Sanuka-cmd-net/lotus-omni/Docs/Architecture.md

# LOTUS OMNI — Architecture Document

## A Superscalar Out-of-Order RISC-V Processor with Systolic Tensor Acceleration,
## Structured Sparsity, and a Congestion-Aware Network-on-Chip

**Author:** Sanuka Nethmira Amarasekara — Lotus Omni (Fabless AI Semiconductor)
**Target FPGA:** Xilinx Artix-7 xc7a200tl-ffv1156-2L
**Timing Status:** Timing-closed OOC @ 80 MHz (WNS +0.252 ns, 0 failing endpoints, 166,090 total endpoints)
**ISA:** RV64I + custom tensor opcode (0x0B)
**RTL Language:** SystemVerilog
**Total Modules:** 30 source files / 35 instantiated modules (all completed, synthesised, and verified)
**Resource Utilisation:** 61,546 LUT (45.73%), 40,250 FF (14.95%), 17 BRAM tiles (4.66%), 64 DSP48E1 (8.65%) — xc7a200t, post-route, zero latches

---

## Table of Contents

1. [Basic Introduction](#1-basic-introduction)
2. [Special Architectures](#2-special-architectures)
3. [Complete Architecture Diagram](#3-complete-architecture-diagram)
4. [Module Status Table](#4-module-status-table)
5. [Front-End Modules](#5-front-end-modules)
6. [Back-End Modules](#6-back-end-modules)
7. [Achievements](#7-achievements)
8. [Development Timeline](#8-development-timeline)
9. [Results Progress](#9-results-progress)
10. [Future Plan](#10-future-plan)
11. [Summary](#11-summary)

---

## 1. Basic Introduction

Lotus Omni is a from-scratch, 4-wide superscalar, out-of-order (OoO) RISC-V core augmented with an AI accelerator subsystem. It was designed, debugged, simulated and timing-closed by a single self-taught engineer, with AI pair-programming assistance. Active RTL development spanned approximately nine months of focused engineering work. The design targets the "AI edge processor" class: a general-purpose OoO scalar pipeline fused with a systolic tensor engine, a three-level memory hierarchy, a TAGE branch predictor, a 2-D mesh Network-on-Chip and credit-based congestion control.

The processor implements the RV64I base integer ISA (64-bit addressing, 32-bit registers with sign/zero extension for word operations) augmented with a custom opcode space at 0x0B for tensor matrix-multiply operations. The scalar pipeline is 4-wide from decode through rename, dispatch, issue, and commit, with a 128-entry Physical Register File (PRF) supporting 8 simultaneous reads and 4 simultaneous writes. Out-of-order execution is managed by partitioned Reservation Stations (implemented depth **RS_DEPTH = 8**, overridden at the top-level integration) with vectorised wakeup and age-based selection, and a 32-entry Reorder Buffer (ROB) enforces in-order retirement with precise exception support.

The tensor accelerator subsystem consists of dual 8x8 systolic arrays (BF16 and INT8), a 2:4 structured sparsity engine, a tensor memory arbiter with CPU-priority arbitration, and a 6-state FSM tensor engine that orchestrates complete 8x8 matrix multiplications in the background while the scalar pipeline continues executing. The memory hierarchy comprises a 32 KB direct-mapped L1 Instruction Cache, a 4 KB write-back L1 Data Cache, and a 16-set 4-way PLRU unified L2 Cache — all using 64-byte cache lines. The L2 is implemented entirely in LUTRAM (zero BRAM), demonstrating a deliberate architectural choice to reserve BRAM resources for the L1I and L1D data arrays.

The on-chip interconnect consists of a 5-port XY-mesh NoC router with per-port FIFO buffers, and a congestion-aware flow control subsystem that deploys credit-based valid/ready flow gates with a PID-like global throttle controller and a 32-cycle sequential divider for utilisation monitoring.

---

## 2. Special Architectures

### 2.1 Out-of-Order Superscalar Execution

Lotus Omni uses a 4-wide superscalar out-of-order pipeline. Up to 4 instructions are fetched, decoded, renamed, dispatched, issued, and committed per cycle. The out-of-order engine uses a physical register file with 128 entries and a free-list for register renaming, partitioned reservation stations with 4 class-specific issue ports, and a reorder buffer for in-order commit. Checkpointed renaming with 8 branch snapshots enables single-cycle mispredict recovery.

### 2.2 TAGE Branch Prediction

The branch predictor uses the TAGE (Tagged Geometric History Length) algorithm with a bimodal base table (1024 entries, 10-bit index), 3 tagged geometric-history tables (256 entries each, 8-bit tags, 3-bit saturating counters), a Branch Target Buffer (BTB, 32 entries), and a Global History Register (GHR). Training updates are pipelined (FIX TAGE-TIMING-02) to meet timing at 80 MHz. A GHR snapshot FIFO (8-deep) ensures training uses the correct historical state.

### 2.3 Outer-Product Broadcast Systolic Arrays (BF16 and INT8)

Both the BF16 and INT8 8x8 systolic arrays use **outer-product broadcast** dataflow. In each feed cycle, one row of activations (a_in_reg[i]) is broadcast to all PEs in row i, and one column of weights (b_in_reg[j]) is broadcast to all PEs in column j. Each PE maintains a **local accumulator** that independently accumulates the partial products over successive feed cycles, computing C[i][j] = SUM_k A[i][k] * B[k][j] without any vertical inter-PE data chain. The clear_acc signal is registered alongside the input data (V5.1 / V2.0 alignment fix) so that accumulator resets align exactly with the first product arriving at the PE adder.

### 2.4 2:4 Structured Sparsity (NVIDIA Ampere/Hopper Style)

The sparsity engine implements 2:4 structured sparsity: for every group of 4 weight values, the two with the largest absolute magnitude are retained and the other two are zeroed. A 3-bit metadata value encodes the selection (6 possible combinations from C(4,2) = 6, fitting exactly in 3 bits). This halves tensor bandwidth and doubles effective throughput. The CSR `sparsity_ctrl` defaults to enabled (`0x01`), but sparsity is disabled at the top level (`assign sparsity_en_csr = 1'b0`) for Artix-7 bring-up; the engine is fully synthesised and can be activated by changing a single assign.

### 2.5 Credit-Based Congestion-Aware Flow Gates

The congestion control subsystem deploys credit-based valid/ready flow gates at the LSU, DRAM, NoC, and tensor boundaries. Each gate contains a 4-deep skid FIFO (LUTRAM-inferred), a credit counter, a throttle counter, and a duty-cycle monitor. A global throttle controller uses a PID-like proportional controller with a 32-cycle shift-subtract sequential divider (FIX V2.2: replaced a combinational divider that was a timing bomb) to compute utilisation percentages and adjust the injection rate.

### 2.6 Checkpointed Register Renaming

The renamer maintains 8 branch checkpoints (RAT snapshot + free-list head/tail/count), enabling single-cycle restoration of architectural state on mispredict recovery. Intra-bundle forwarding handles WAW hazards within the same 4-wide dispatch bundle without waiting for CDB broadcast. The output is pipelined through a registered stage (FIX REN-TIMING-02) to break a critical timing path.

### 2.7 ASIC-Portable Coding Style

The entire codebase follows ASIC-portable conventions: synchronous resets on all DSP-mapped modules (enabling DSP48 SR packing), reset-free BRAM write paths for proper SRAM inference, one-hot arbitration for scalable muxing, and no FPGA-specific DSP attributes in the BF16 multiplier (V4.0). The BF16 multiplier uses a direct 8x8 multiply that synthesis tools can map to the optimal ASIC multiplier topology (Wallace tree, Booth encoded, or array).

---

## 3. Complete Architecture Diagram

The following line diagram illustrates the complete data-flow architecture of Lotus Omni, including all modules, data paths, memory hierarchy, tensor accelerator subsystem, and Network-on-Chip interconnect.

```
                         LOTUS OMNI — COMPLETE ARCHITECTURE
                         ====================================

                          +------------------------------ FRONT-END -----------------------------+
                          |                                                                      |
   PC ------>+-------  req  +-----------+  512b  +------------+ 16xuop +------------+ 4xren_uop  |
   ^        |  IFU   |----->| L1I CACHE|------>|  DECODER   |------>|  RENAMER   |----------+  |
   |        |16-wide |<-----|512-set DM|       | 16-wide    |       |RAT+FreeLst|          |  |
   +--------+---^----+ hit  +----^-----+       +------------+       +-----^------+          |  |
   |  pred  |     |           |                        |                | save/restore    |  |
   | +------+-----+           |            +-------------+           | checkpoint      |  |
   +--|   TAGE     |          +----------->|   L2 CACHE  |<----------+ |                 |  |
      | +BTB +GHR  |                      |16-set 4-way  |            | |                 |  |
      +------------+                      |    PLRU     |            | |                 |  |
                          +---------------+------^------+------------+ | |                 |  |
                          |                      | 1024b DRAM beat  | | |                 |  |
                          |               +------v-----+             | | |                 |  |
                          |               | DRAM GATE  |             | | |                 |  |
                          |               +-----+------+             | | |                 |  |
                          +---------------------+--------------------+ | |                 |  |
                                                v                      | |                 |  |
                                           [ DRAM PORT ]               | |                 |  |
                                                                       | |                 |  |
  +----------------------------- BACK-END ------------------------------+-+-----------------+--+
  |                                       +----------------------------v-v--------+         |  |
  |  4xren_uop +---------------+  dispatch |           ROB (32)                |         |  |
  | +-------->| RESERVATION   |--------->| in-order commit . banked RAM    |         |  |
  | |         |  STATIONS     |          +-------+-------------^-----------+         |  |
  | | wakeup  | (partitioned) |                  |commit(4)     |cdb(4, registered)   |  |
  | | <-------+--|---+---+----+                  v              |                     |  |
  | |         |  |   |   |   |              +-----------+  +----+-------------------+ |  |
  | |         v  v   v   v   |              |    PRF    |  |       CDB MUX          | |  |
  | |        +----+ +--+ +----+--------+   |128x64 8R4W|<-+- ALU|BR|LD|CSR+TENSOR  | |  |
  | |        |ALU | |BR | |AGU  |TENSOR/  |  +-----^----+  +--^----^----^------^-----+ |  |
  | |        |    | |   | |+LSQ | CSR     |       |rd(8)      |    |    |      |       |  |
  | |        +--^-+ +--^-+ +--^--+--^-----+       |wr(4)      |    |    |      |       |  |
  | |           |      |      |     |               |           |    |    |      |       |  |
  | +-----------+------+------+-----+---------------+           |    |    |      |       |  |
  |                                                           |    |    |      |       |  |
  |  issue(4)                                                  |    |    |      |       |  |
  +-----------------------------------------------------------+    |    |      |       |  |
                                                                   |    |    |      |       |  |
      +------------------------------------------------------------+    |    |      |       |  |
      |                                                                 |    |      |       |  |
      |  +--------------------------------------------------------------+    |      |       |  |
      |  |                                                                   |      |       |  |
      |  |  +----------------------------------------------------------------+      |       |  |
      |  |  |                                                                          |       |  |
      v  v  v  v  v  v  v                                                                  |       |  |
    [P0][P1][P2][P3] issue ports --> ALU / Branch / AGU+LSQ / Tensor+CSR                |       |  |
                               |                |                                         |       |  |
                               |   +------------+---------------+                         |       |  |
                               |   |  LSQ (16) -- STL fwd -->L1D |                         |       |  |
                               |   |        |            +------v------+                  |       |  |
                               |   |        +----------->|  L1D CACHE  |                  |       |  |
                               |   |                     |64-line WB   |                  |       |  |
                               |   |                     +------^------+                  |       |  |
                               |   |                            | miss                    |       |  |
                               |   |                     +------v------+                  |       |  |
                               |   |                     | TENSOR MEM  |<-- tensor req    |       |  |
                               |   |                     |  ARBITER    |    (background)  |       |  |
                               |   |                     | CPU-priority|                  |       |  |
                               |   |                     +------^------+                  |       |  |
                               |   |                            |                         |       |  |
                               |   |   +------------------------v-------------------------+      |       |  |
                               |   |   |  TENSOR ENGINE FSM (IDLE->MEM->FEED->DRAIN->WB)|     |       |  |
                               |   |   |   +---------------+   +---------------+          |     |       |  |
                               |   |   |   | 8x8 BF16 SYS  |   | 8x8 INT8 SYS  |          |     |       |  |
                               |   |   |   | outer-product |   | outer-product |          |     |       |  |
                               |   |   |   | broadcast     |   | broadcast     |          |     |       |  |
                               |   |   |   +-------^-------+   +-------^--------+         |     |       |  |
                               |   |   |           |            +-------v--------+         |     |       |  |
                               |   |   |   +-------v-------+    | SPARSITY 2:4 |          |     |       |  |
                               |   |   |   | 2:4 COMPRESS  |<---|  engine       |          |     |       |  |
                               |   |   |   +---------------+    +---------------+          |     |       |  |
                               |   |   +---------------------------------------------------+      |       |  |
                               |   +----------------------------------------------------------+      |       |  |
                               |                                                                  |       |  |
                               |   +--------------------------------------------------------------+   |       |  |
                               +-->|  NOC ROUTER (5-port XY, RR) --> flow gates --> tx/rx       |---+       |  |
                                   +--------------------------------------------------------------+           |  |
                                                                                                          |  |
                                                                                                          +--+

  DATA-FLOW SUMMARY:
  ================
  Scalar path:  Fetch --> L1I --> Decode --> Rename --> RS --> {ALU, BR, AGU/LSQ, TEN/CSR} --> CDB --> PRF/ROB --> Commit
  Memory path:  LSQ --> L1D --> (miss) --> Arbiter --> L2 --> (miss) --> DRAM-gate --> DRAM
  Tensor path:  Engine --> Arbiter --> L1D --> L2
  NoC path:     Router (5-port XY mesh) --> Flow gates --> tx/rx --> neighbouring tiles
```

---

## 4. Module Status Table

All 30 source files are **completed**: synthesised, behaviourally simulated, and (for the full core) timing-closed out-of-context at 80 MHz. The 30 files map to 35 instantiated modules; 4 internal submodules (`decoder_diq_bank`, `rs_payload_bank`, `pf_fifo_4deep`, `noc_fifo_storage`) are generated or instantiated within their parent modules.

| # | Module | Function | Status |
|---|---|---|---|
| 1 | `lotus_ifu_masterpiece` | 16-wide fetch, deadlock-free request channel (V1.1) | Completed |
| 2 | `lotus_l1i_cache` | 512-set DM I-cache, 32 KB, 64 B/line, BRAM, 5-state FSM (V4.2) | Completed |
| 3 | `lotus_tage_predictor` | TAGE+BTB branch predictor with pipelined training (V2.8) | Completed |
| 4 | `lotus_decoder_masterpiece` | 16-wide decode, 128-entry 16-bank LUTRAM DIQ (V4.0) | Completed |
| 5 | `lotus_renamer_masterpiece` | RAT + free-list, 8 branch checkpoints, registered output (V3.3) | Completed |
| 6 | `lotus_reservation_station_v4` | Partitioned RS, vectorised wakeup/selection, pure-arith occupancy (V5.8) | Completed |
| 7 | `lotus_prf` | 128x64b 8R/4W PRF, registered one-hot arbitration, deferral queue | Completed |
| 8 | `lotus_alu_masterpiece` | RV64I ALU, 2-stage EX1/EX2 pipeline with OR-AND forwarding (V4.3 - ALU-DEADLOCK-001) | Completed |
| 9 | `lotus_branch_exec` | Branch/jump resolve, mispredict detection, proper branch_tag (V2.1 - BRANCH-DEADLOCK-01) | Completed |
| 10 | `lotus_agu` | Address generation, 9-bit wmask, misalign detect, latch-free (V1.2) | Completed |
| 11 | `lotus_lsq_masterpiece` | 16-entry SQ, CAM store-to-load forwarding, registered drain (V3.8) | Completed |
| 12 | `lotus_l1d_cache` | 64-line WB data cache, 4 KB, 64 B/line, 512-bit resp, 7-state 
FSM w/ MMIO_SINK (V8.1) | Completed |
| 13 | `lotus_l2_cache` | 16-set 4-way PLRU unified L2, LUTRAM-only, 4-entry queue (V7.6) | Completed |
| 14 | `lotus_prefetcher` | Stride prefetcher, RPT + 4-deep queue, fixed FIFO (V1.6) | Completed |
| 15 | `lotus_rob_masterpiece` | Banked-RAM ROB, 32-entry, 4-wide commit, registered CDB (V8.3) | Completed |
| 16 | `lotus_tensor_engine` | MATMUL FSM, 6-state, internal CDB writeback, dataflow-aligned (v3.0.0) | Completed |
| 17 | `lotus_bf16_systolic_array_8x8_v3` | 8x8 BF16 outer-product broadcast, local accumulation (V5.1) | Completed |
| 18 | `lotus_int8_systolic_array_8x8` | 8x8 INT8 outer-product broadcast, local accumulation (V2.0) | Completed |
| 19 | `lotus_bf16_tensor_pe` | DSP-mapped BF16 MAC PE, 3-stage, local acc, operand isolation (V10.0) | Completed |
| 20 | `lotus_sparsity_engine_v3` | 2:4 structured sparsity compressor, backpressure hold (V3.4 - SPARSE-HS-001) | Completed |
| 21 | `lotus_tensor_mem_arbiter` | CPU-priority L1D arbiter, 12 SVA assertions (v2.1.0) | Completed |
| 22 | `lotus_noc_router_masterpiece` | 5-port XY mesh NoC router, LUTRAM FIFO, set/reset safe (V3.2 - NOC-P0-001) | Completed |
| 23 | `congestion_aware_flow_gate` | Credit-based flow gate, 4-deep LUTRAM skid FIFO, credit/throttle counters (V2.3 - DEADLOCK FIX) | Completed |
| 24 | `flow_gate_array` | Parametric array of N parallel flow gates with global throttle (V1.0) | Completed |
| 25 | `global_throttle_controller` | PID-like proportional controller, 32-cycle sequential divider (V1.0) | Completed |
| 26 | `lotus_csr` | Machine-mode CSRs + custom tensor/sparsity CSRs + FENCE/FENCE.I (V1.1) | Completed |
| 27 | `lotus_pmu` | 13-counter hardware PMU, shift-based IPC, pipelined counters | Completed |
| 28 | `lotus_axi4_wrapper` | AXI4-Lite control-plane, internal tensor CDB, glitch-free reset (V2.0) | Completed |
| 29 | `lotus_omni_core_top_v2` | Top-level integration, timing pipelines, all bugs fixed | Completed |
| 30 | `lotus_pkg` | Shared parameter/typedef package, 30+ structs (uop_t, rs_entry_t, etc.) | Completed |
| 31 | `lotus_bf16_mult` | ASIC-portable BF16 multiplier, 3-stage exp/mantissa pipeline (V4.0) | Completed |
| 32 | `lotus_tensor_pe` | INT8 MAC PE, 3-stage, DSP48E2-ready, saturation, sparsity skip (V3.0) | Completed |
| 33 | `decoder_diq_bank` | 8-entry LUTRAM DIQ bank (submodule of decoder, 16 banks total) | Completed |
| 34 | `rs_payload_bank` | RS entry payload storage bank (submodule of reservation station) | Completed |
| 35 | `pf_fifo_4deep` | 4-deep prefetch FIFO (submodule of stride prefetcher) | Completed |
| 36 | `noc_fifo_storage` | NoC router FIFO storage (submodule of NoC router) | Completed |

All 30 source files are **completed**: synthesised, behaviourally simulated, and (for the full core) timing-closed out-of-context at 80 MHz. The 30 files map to 35 instantiated modules; the additional files include supporting modules (`lotus_pkg`, `lotus_bf16_mult`, `lotus_tensor_pe`, `lotus_axi4_wrapper`) and 4 internal submodules (`decoder_diq_bank`, `rs_payload_bank`, `pf_fifo_4deep`, `noc_fifo_storage`) generated or instantiated within their parent modules.

---

## 5. Front-End Modules

The front-end is responsible for fetching instructions from memory, predicting branch directions and targets, decoding RISC-V instructions into micro-operations, and renaming architectural registers to physical registers to eliminate false dependencies. It operates as a wide 16->4 funnel that feeds the back-end's out-of-order engine.

---

### 5.1 Instruction Fetch Unit — `lotus_ifu_masterpiece`

**Module Description**

The Instruction Fetch Unit (IFU) is the entry point of the pipeline. It fetches one 64-byte (16-instruction) cache line per cycle from the L1 Instruction Cache, maintaining the Program Counter (PC). The IFU accepts branch redirect targets from the TAGE predictor and pipeline flush signals from the back-end (on mispredict or exception). A critical design decision is the decoupled request channel: if the back-end stalls, the IFU does not deadlock — it simply stops issuing new requests but can still accept and process redirects (FIX IFU-001). This property of guaranteed forward progress is essential for the health of the entire pipeline, since a deadlocked fetcher would permanently halt the processor.

**Mathematical Formulation (with Worked Example)**

The PC update follows a three-way mux governed by flush, stall, and prediction conditions:

```
             +-- flush_target                          if flush
             |
PC(t+1)  =  +-- PC(t)                                 if stall OR flush OR backend_stall
             |
             +-- pred_taken ? pred_target : PC(t)+64   otherwise
                                                        (Eq. F1)
```

Where:
- `backend_stall = out_valid AND NOT dec_ready` (the decoder cannot accept more instructions)
- `stall = NOT l1i_req_ready` (the L1I cache cannot accept a new request this cycle)

**Worked Example:**
- Scenario 1: `PC = 0x8000_0000`, no branch predicted, no stall.
  - `PC(t+1) = 0x8000_0000 + 64 = 0x8000_0040` (sequential fetch of the next 16 instructions)
- Scenario 2: TAGE predicts taken branch to target `0x8000_1000`.
  - `PC(t+1) = 0x8000_1000` (non-sequential redirect to the predicted target)
- Scenario 3: Back-end stall (`backend_stall = 1`).
  - `PC(t+1) = 0x8000_0040` (PC holds, no new request issued, but the IFU stays alive to process flushes)

**Contribution to the Chip**

The IFU sustained the 16-wide fetch bandwidth needed for 4-wide dispatch with decoupling that prevents fetch-deadlock. FIX IFU-001 separated the cache request path from the backend stall path, ensuring the fetcher can continue making forward progress (accepting redirects, maintaining liveness) even when the decoder is temporarily unable to accept new instructions. This decoupling is essential in a deep out-of-order pipeline where back-end stalls (ROB full, LSQ full, cache misses) are frequent.

---

### 5.2 L1 Instruction Cache — `lotus_l1i_cache`

**Module Description**

The L1 Instruction Cache is a 512-set direct-mapped cache with 64-byte (512-bit) cache lines, yielding 32 KB of instruction storage. It uses a 5-state FSM: `IDLE -> READ_RAM -> READ_REG -> COMPARE -> ALLOCATE`. The data and tag arrays are BRAM-inferred (`(* ram_style = "block" *)`) with no reset on the SRAM arrays to ensure proper BRAM inference on both FPGA and ASIC targets. A separate `valid_bits` array (flip-flops, resettable) tracks which cache lines contain valid data. The BRAM output is captured in a registered stage (`READ_REG` absorbs the BRAM output register latency) before tag comparison. FIX V4.1 corrected the array declarations from `[NUM_SETS-1]` to `[0:NUM_SETS-1]` to ensure all 512 elements are properly synthesised (SYNTH-8-324).

**Mathematical Formulation (with Worked Example)**

```
index   = PC[INDEX_BITS+OFFSET_BITS-1 : OFFSET_BITS]     (9 bits for 512 sets)   (Eq. F2)

is_hit  = valid_read_q AND (tag_read_q == addr_tag)                                  (Eq. F3)

evict_line = addr_index  (direct-mapped: only one candidate)                        (Eq. F4)
```

**Worked Example:**
- `PC = 0x8000_1000`, `NUM_SETS = 512`, `OFFSET_BITS = 6`.
- `index = PC[14:6] = 0x040` (set 64).
- `tag = PC[63:15]` (49-bit tag, upper address bits).
- FSM cycle trace: `IDLE` (req accepted) -> `READ_RAM` (BRAM address registered) -> `READ_REG` (BRAM output captured) -> `COMPARE` (tag match: hit? if yes, return data; if no, issue memory request) -> `ALLOCATE` (fill from memory on miss).

**Contribution to the Chip**

The L1I Cache supplies 16 instructions per cycle to the decoder, sustaining the front-end's fetch bandwidth. The 32 KB size (512 sets x 64 B) provides good instruction locality for typical program working sets. The reset-free BRAM design is critical for both area efficiency (avoiding flip-flop implementation) and ASIC portability (hardware SRAM cells cannot be reset in a single cycle). The V4.1 array declaration fix (SYNTH-8-324) ensured that all 512 cache entries are properly synthesised rather than a single-element array.

---

### 5.3 TAGE Branch Predictor — `lotus_tage_predictor`

**Module Description**

The TAGE predictor uses a bimodal base table (1024 entries x 2-bit saturating counters, indexed by `PC[9:2]`) and 3 tagged geometric-history tables (T1/T2/T3, each 256 entries x 3-bit counters with unique tags). Each table uses a different GHR history length for varying prediction power at different branch correlation distances. A Branch Target Buffer (BTB, 32 entries) caches branch targets. The Global History Register (GHR) tracks the last 16 branch outcomes. Training updates are pipelined (FIX TAGE-TIMING-02): table writes use registered indices and tags from Stage 1, breaking a critical combinational path from the prediction output to the update logic. A GHR snapshot FIFO (8-deep, FIX TAGE-001) captures the GHR state at fetch time and replays it at training time, ensuring correct training alignment despite the pipeline latency between fetch and resolution.

**Mathematical Formulation (with Worked Example)**

```
bimodal_idx = PC[9:2]                                              (Eq. F5)

t{i}_idx = PC ^ GHR[hist_len{i}-1 : 0]                           (Eq. F6)

prediction = longest-match tagged table that hits, else bimodal

ctr_update = clamp( ctr +/- 1, 0, max )                           (Eq. F7)
```

Counter update: `ctr <- clamp(ctr +/- 1, 0, 7)`. New allocation: `ctr = 4` (if taken) or `ctr = 3` (if not-taken) — weakly biased toward the observed direction.

**Worked Example:**
- `PC[9:2] = 0x10` (binary: `0001_0000`), `GHR = 0x000F` (binary: `0000_0000_0000_1111`).
- `t1_idx = 0x10 XOR 0x0F = 0x1F` (index 31 in T1 table).
- `t1_tag = 0x10 XOR 0x0F = 0x1F` (tag to compare).
- Suppose T1[31] is valid, its tag matches 0x1F, and its counter is 5 (binary `101`).
- Prediction: `ctr[2] = 1` -> **taken**.
- If the branch is actually taken, the counter increments: `5 + 1 = 6`.
- If the branch is actually not-taken (misprediction), the counter decrements: `5 - 1 = 4`.

**Contribution to the Chip**

The TAGE predictor cuts control-hazard flushes, which are one of the most expensive events in a deep pipeline. Each saved mispredict is a full pipeline refill (10+ cycles) recovered. In a typical workload with 15-25% branch instructions, even a modest accuracy improvement of 5% over a simple bimodal predictor translates to significant IPC gains. The GHR-snapshot FIFO (the key innovation for training alignment) and the pipelined training update (TAGE-TIMING-02) ensure the predictor trains on the correct global history state, preventing accuracy degradation.

---

### 5.4 Decoder — `lotus_decoder_masterpiece`

**Module Description**

The Decoder is a 16-wide parallel instruction decoder that converts raw RISC-V 32-bit instruction words into internal micro-operation (`uop_t`) structures. Decoded micro-operations are buffered in a 128-entry Decoded-Instruction Queue (DIQ), which is striped across 16 LUTRAM banks to avoid the read-port bottleneck that a monolithic RAM would create. The decoder dispatches 4 micro-operations per cycle to the renamer, matching the back-end's 4-wide dispatch bandwidth. A key timing optimisation (FIX DEC-TIMING-001) replaced a 16-iteration accumulator loop with a parallel `$countones` and simple min logic, and FIX DEC-TIMING-002 replaced a 16-to-1 priority encoder with a barrel-rotate write mux — together reducing the combinational depth from 75 logic levels to just 4. FIX DEC-TIMING-003 changed to synchronous reset to eliminate async reset recovery timing violations.

**Mathematical Formulation (with Worked Example)**

```
req     = popcount( valid_mask[15:0] )                              (Eq. F8)
count'  = count + enq - ndis        (9-bit intermediate, no wrap)     (Eq. F9)
bank b  = instr i where i = (b - tail[3:0]) mod 16                    (Eq. F10)
gaddr   = (tail + i) mod 128                                         (Eq. F11)
```

**Worked Example:**
- `valid_mask = 0x00FF` (lower 8 instructions are valid in the current fetch bundle).
- `req = popcount(0x00FF) = 8` (8 valid instructions to decode).
- With `tail = 3`, instruction `i=0` maps to bank `b = (0 - 3) mod 16 = 13`, and `gaddr = (3 + 0) mod 128 = 3`.
- Instruction `i=1` maps to bank `b = 14`, `gaddr = 4`.
- The barrel-rotate write mux maps each instruction to its target bank in a single level of MUX logic, instead of the cascaded priority chain that caused the timing violation.

**Contribution to the Chip**

The Decoder sustains the 16->4 funnel without becoming a bottleneck. The parallel popcount and barrel-rotate architecture removed the two deepest combinational chains in the front-end, directly contributing to timing closure. Without this fix, the decoder alone would have prevented the design from reaching 80 MHz. The 128-entry DIQ provides buffering that absorbs the mismatch between the 16-instruction fetch width and the 4-instruction dispatch width, allowing the fetch and rename stages to operate independently. The DIQ banks use flattened struct arrays (FIX DEC-P1-001) for perfect LUTRAM inference, with each field (`pc`, `opcode`, `dest_reg`, `src1_reg`, `src2_reg`, `imm_data`, `funct3`, `funct7`, `is_tensor_op`, `precision`, `is_branch`, `is_memory`, `is_illegal`, `is_csr`, `valid`) stored as a separate `(* ram_style = "distributed" *)` array.

---

### 5.5 Renamer — `lotus_renamer_masterpiece`

**Module Description**

The Renamer maps the 32 architectural registers defined by the RISC-V ISA onto 128 physical registers in the Physical Register File (PRF). This register renaming eliminates false dependencies — Write-After-Write (WAW) and Write-After-Read (WAR) hazards — so that the out-of-order engine can exploit genuine data parallelism (Read-After-Write, or RAW, dependencies). The renamer maintains a Register Alias Table (RAT) that maps each architectural register to its current physical register, and a free-list that tracks which physical registers are available for allocation.

The renamer also performs intra-bundle forwarding: if multiple instructions in the same 4-wide dispatch bundle write to the same architectural register (e.g., two back-to-back `addi x1, x0, 1`), the later instruction sees the earlier one's physical destination without waiting for the CDB. Eight checkpointed snapshots (RAT + free-list head/tail/count) are maintained for single-cycle branch mispredict recovery. The output is pipelined through a registered stage (FIX REN-TIMING-02) to break a critical timing path. Shallow allocation and commit count logic (FIX REN-TIMING-01) keeps the combinational depth minimal. Additional fixes include complete free-list reset initialisation (REN-003), free-list value wrap-around skipping p0 (REN-004), and synchronous reset (REN-005).

**Mathematical Formulation (with Worked Example)**

```
p_dest[i] = FL[ ( fl_head + SUM_{j<i} a_j ) mod 128 ],  a_j = [dest_j != 0]   (Eq. F12)

fl_head' = fl_head + SUM a_i
fl_tail' = fl_tail + SUM c_i                                               (Eq. F13)

rename_ready = ( fl_count >= 4 )                                           (Eq. F14)
```

Where `a_j = 1` if instruction `j` in the bundle writes a non-zero architectural register (i.e., it needs a new physical register), and `c_i = 1` when a committed instruction frees its old physical register.

**Worked Example:**
- `fl_head = 40`, and the dispatch bundle has two writers: slot 0 writes to `x3` and slot 2 writes to `x5`.
- `a_0 = 1` (x3 != 0), `a_1 = 0` (slot 1 has no destination), `a_2 = 1` (x5 != 0), `a_3 = 0`.
- `p_dest[0] = FL[(40 + 0) mod 128] = FL[40]` (first available physical register).
- `p_dest[2] = FL[(40 + 1) mod 128] = FL[41]` (second available physical register).
- `fl_head' = 40 + 1 + 1 = 42` (two physical registers consumed).
- `rename_ready = (fl_count >= 4)` — if fewer than 4 physical registers are free, the renamer back-pressures the decoder.

**Contribution to the Chip**

The Renamer is the enabler of out-of-order execution. Without register renaming, the processor could only issue instructions in program order because of false dependencies. By eliminating WAW and WAR hazards, the renamer allows the 4 issue ports to extract instruction-level parallelism from independent operations — for example, issuing two independent `add` instructions in the same cycle even if a previous (but unrelated) `mul` is still executing. The 8-checkpoint system bounds the branch-misprediction penalty to a single cycle of state restoration, which is critical for the TAGE predictor's effectiveness.

---

## 6. Back-End Modules

The back-end is the out-of-order execution engine. It receives renamed micro-operations from the front-end, dispatches them into partitioned Reservation Stations where they wait for their operands, issues them to execution units when ready, broadcasts results on the Common Data Bus, and retires completed instructions in program order through the Reorder Buffer. The back-end also contains the memory subsystem (LSQ, L1D, L2, prefetcher), the tensor accelerator subsystem (systolic arrays, sparsity engine, tensor memory arbiter), and the on-chip interconnect (NoC router, congestion flow gates).

---

### 6.1 Reservation Stations — `lotus_reservation_station_v4`

**Module Description**

The Reservation Stations (RS) are the heart of out-of-order execution — they implement the dataflow firing model where instructions execute as soon as their operands are ready, regardless of their original program order. The RS is partitioned into 4 class-specific ports: Port 0 (ALU), Port 1 (Branch), Port 2 (Memory/AGU/LSQ), and Port 3 (Tensor/CSR). Each entry stores the micro-operation's opcode, destination physical register, source physical register numbers, operand validity bits, and the ROB index for in-order tracking.

The Reservation Station (RS) is a partitioned structure with an **implemented depth of 8 entries** (RS_DEPTH = 8, set by top-level override in `lotus_omni_core_top_v2`; note: the `lotus_pkg` comment still reads 16, which is stale — the actual synthesised depth is 8). Entries wait for operand readiness through two mechanisms: (1) checking `prf_ready_bits` (set when the PRF write completes), or (2) waking up from CDB broadcasts (when another execution unit writes a result that matches a waiting entry's source register). Once both operands are ready, the entry becomes a candidate for issue. A vectorised parallel matcher selects the oldest ready entry per port, and the selected entry is issued to the corresponding execution unit. The issue count is pipelined (FIX RS-TIMING-02) and the occupancy counter uses pure arithmetic without conditional clamps (FIX RS-TIMING-03), which removed a 2.282 ns critical path. The RS payload is stored in isolated `rs_payload_bank` sub-modules (FIX RS-006) with registered write addresses for distributed RAM inference.

**Mathematical Formulation (with Worked Example)**

```
r{k}_s' = r{k}_s OR  ( cdb_valid[p] AND (cdb_p_dest[p] == p_src{k}_s) )    (Eq. B1)

occ'   = occ + dispatch_count - issue_count_q       (no clamps needed)     (Eq. B2)

rs_ready = NOT( occ >= RS_DEPTH - 4 )                                      (Eq. B3)
```

**Worked Example:**
- Current occupancy `occ = 6`, dispatch 2 new entries, issue 1 entry.
- `occ' = 6 + 2 - 1 = 7`.
- `rs_ready = NOT(7 >= RS_DEPTH - 4)`. If `RS_DEPTH = 8`, then `rs_ready = NOT(7 >= 4) = NOT(true) = 0` (not ready to accept more dispatches).
- CDB broadcast: port 2 writes `p_dest = 17` with `cdb_valid[2] = 1`.
- Every RS entry waiting on source register 17 has its ready bit set to 1 in a single cycle (Eq. B1).

**Contribution to the Chip**

The Reservation Stations implement dataflow firing — the fundamental mechanism of out-of-order execution. The occupancy arithmetic fix (replacing comparators with pure add/subtract) removed a 2.282 ns critical path that was one of the top timing violations in the design. The partitioned port structure ensures that ALU, branch, memory, and tensor operations do not compete for the same issue bandwidth.

---

### 6.2 Physical Register File — `lotus_prf`

**Module Description**

The Physical Register File (PRF) is a 128-entry, 64-bit-wide register file with 8 read ports and 4 write ports, implemented using distributed-RAM banks. The high port count (8R/4W) is required to serve the 4 issue ports (each reading 2 source operands) and 4 CDB write-backs simultaneously. Same-address write collisions (two execution units writing to the same physical register in the same cycle) are resolved by granting the write to the entry with the youngest ROB index; the older writer is deferred to a 4-deep deferral queue. A `prf_stall` backpressure signal prevents the queue from overflowing during burst write periods. Read-after-write (RAW) forwarding covers the +1-cycle write latency: if a read and write to the same address occur in the same cycle, the read gets the write data directly rather than the stale RAM value.

The arbitration is registered and one-hot (FIX ASIC-TIMING-001 / PRF fix), which was the single most impactful timing fix in the entire design — it improved the Worst Negative Slack (WNS) by 7.019 ns, taking the design from deeply negative to nearly positive slack in a single change.

**Mathematical Formulation (with Worked Example)**

```
grant = one_hot( chosen )
prf_commit_valid = grant_valid_q                                          (Eq. B4)

prf_stall = ( queue_count >= QDEPTH - 1 )                                (Eq. B5)

rd[p] = ( grant_valid AND rd_addr[p] == grant_addr )
         ? grant_data
         : bank[ rd_addr[p] ]                                             (Eq. B6)
```

**Worked Example:**
- Ports 0 and 2 both write to `p_dest = 33` in the same cycle.
- Port 0's `rob_idx = 12`, Port 2's `rob_idx = 15`. Since 15 > 12 (younger), Port 2 wins the grant this cycle.
- Port 0's write is deferred to the deferral queue and will be written next cycle.
- A read of physical register 33 in the grant cycle forwards `grant_data` (Port 2's value) directly, avoiding the stale RAM value.

**Contribution to the Chip**

The PRF is the central data structure of the out-of-order machine — every operand read and every result write passes through it. The registered one-hot arbitration was the design's worst timing path; fixing it (changing from combinational priority arbitration to a registered one-hot grant) improved WNS by 7.019 ns. This single fix made the entire 8R/4W PRF timing-feasible on the Artix-7 FPGA at 80 MHz.

---

### 6.3 ALU — `lotus_alu_masterpiece`

**Module Description**

The Arithmetic Logic Unit (ALU) executes all RV64I integer arithmetic and logic operations: addition, subtraction, shifts (logical and arithmetic), bitwise logic (AND, OR, XOR), set-less-than comparisons, and word-width operations (32-bit variants with sign/zero extension). The ALU is pipelined into two stages (FIX ALU-TIMING-01, V4.2): EX1 registers the forwarded operands and control signals from the CDB/PRF, and EX2 performs the actual computation and registers the result for the CDB broadcast. This 2-stage structure splits the original 27-level combinational path (forwarding mux -> 64-bit adder -> output) into approximately 14 + 13 logic levels, improving WNS by 4.304 ns. The ALU latency increases from 1 to 2 cycles, which is absorbed by the OoO scheduler/ROB (dependent instructions simply wake up 1 cycle later). The `word_result` latch fix (ALU-LATCH-001) and the parallel OR-AND forwarding mux (ASIC-TIMING-001) are preserved.

**Mathematical Formulation (with Worked Example)**

```
m_p = cdb_valid[p] AND (p_src == cdb_p_dest[p]) AND (p_src != 0)      (Eq. B7)

src = ( OR_p m_p )
        ? OR_p ( m_p ? cdb_data[p] : 0 )
        : prf_data                                                     (Eq. B8)

result = f(opcode, funct3, funct7, src1_q, op2)                       (Eq. B9)
```

**Worked Example:**
- Instruction: `add x3, x1, x2` (RV64I ADD).
- EX1: Source operands after forwarding: `src1 = 5, src2 = 7`. Registered into `src1_q, src2_q`.
- EX2: `result = 5 + 7 = 12` (0xC).
- The result `12` is broadcast on the CDB to wake dependents and written to `PRF[p_dest]`.

**Contribution to the Chip**

The ALU is the primary execution unit for general-purpose code. The 2-stage pipeline split the original 27-level issue->mux->adder chain into approximately 14 + 13 logic levels, improving WNS by 4.304 ns. The OR-AND forwarding structure ensures that the forwarding mux depth does not grow with the number of CDB ports.

---

### 6.4 Branch Executor — `lotus_branch_exec`

**Module Description**

The Branch Executor resolves all RV64I branch and jump instructions (BEQ, BNE, BLT, BGE, BLTU, BGEU, JAL, JALR). It compares the two source operands (from forwarded CDB/PRF data), determines whether the branch is taken, computes the branch target, and detects mispredictions by comparing the actual outcome against the TAGE predictor's prediction. On a mispredict, it emits the correct PC and the RS entry's branch tag, which the renamer uses to restore the appropriate checkpoint. FIX HIGH-001 removed a hardcoded `branch_tag_out = 3'h0` that would have caused all 8 branch checkpoints to use slot 0, preventing independent speculative execution of multiple in-flight branches.

**Mathematical Formulation (with Worked Example)**

```
taken(BEQ)  = (s1 == s2)
taken(BNE)  = (s1 != s2)
taken(BLT)  = (signed s1 <  signed s2)
taken(BGE)  = (signed s1 >= signed s2)
taken(BLTU) = (unsigned s1 <  unsigned s2)
taken(BGEU) = (unsigned s1 >= unsigned s2)                             (Eq. B10)

mispredict = ( taken != pred_taken )
           OR ( taken AND target != pred_target )                         (Eq. B11)
```

**Worked Example:**
- TAGE predicted: not-taken.
- Actual instruction: `BEQ x5, x6, target` with `s1 = s2 = 9`.
- `taken(BEQ) = (9 == 9) = 1` (branch is taken).
- `mispredict = (1 != 0) = 1` — **mispredict detected**.
- Action: `correct_pc = PC + imm`, `branch_tag_out = issue_branch_tag` (from RS entry, not hardcoded).
- The renamer restores the checkpoint associated with this tag, flushing all younger instructions.

**Contribution to the Chip**

The Branch Executor closes the branch-resolution loop — it is the ground truth against which the TAGE predictor's speculations are checked. Correct branch-tag propagation (after FIX HIGH-001) enables the renamer's 8 independent checkpoints to work correctly, ensuring that each mispredict recovers precisely to the correct architectural state.

---

### 6.5 Address Generation Unit — `lotus_agu`

**Module Description**

The Address Generation Unit (AGU) computes effective memory addresses for load and store instructions. It adds the base register value (rs1) to the sign-extended immediate, generates byte-level write masks for sub-word stores (LB/SB, LH/SH, LW/SW, LD/SD), and detects misaligned accesses. FIX AGU-LATCH-001 added a default assignment `wmask_9 = 9'h1FF` at the top of the combinational block to prevent a latch from being inferred on `wmask_9` — previously, the 3'b011 (LD/SD 8-byte) case set `wmask_comb = 8'hFF` but left `wmask_9` undriven, causing Vivado to infer a latch.

**Mathematical Formulation (with Worked Example)**

```
addr     = base + imm
wmask_9  = base_mask << addr[2:0]          (9-bit intermediate)
wmask    = wmask_9[7:0]                                              (Eq. B12)

misalign: 1B -> never misaligned
          2B -> addr[0]
          4B -> |addr[1:0]
          8B -> |addr[2:0]                                            (Eq. B13)
```

**Worked Example:**
- `SW x5, 0x06(x0)` — store a 4-byte word to address `0x...06`.
- `wmask_9 = 0x0F << 6 = 0x3C0`, `wmask = 0xC0` (bytes 6 and 7 selected, but only 2 bytes for a 4-byte store at offset 6 indicates misalignment).
- `misalign = |addr[1:0] = |0b10 = 1` — **misalignment exception raised**.

**Contribution to the Chip**

The AGU feeds the Load-Store Queue with correctly computed addresses and write masks, and raises precise misalignment exceptions. FIX AGU-LATCH-001 eliminated a latch that would have caused undefined behavior in the write-mask generation path, ensuring clean synthesis without latch warnings.

---

### 6.6 Load-Store Queue — `lotus_lsq_masterpiece`

**Module Description**

The Load-Store Queue (LSQ) contains a **16-entry store queue** (SQ_DEPTH = 16, module-level default) with CAM (Content-Addressable Memory) style store-to-load forwarding. When a load instruction executes, the LSQ searches all older valid stores for an address match using a vectorised parallel match. The match vector is rotated by the tail pointer so that the youngest older matching store wins (correct memory ordering). A 2-cycle forwarding pipeline (FIX LSQ-TIMING-03) separates the match computation from the data selection. A shallow drain-hold mechanism (FIX LSQ-TIMING-03b) prevents load/store hazards during drain by detecting head-address matches. Committed stores drain one per cycle to the L1D Cache using pre-read registered head data (FIX LSQ-TIMING-04). Data registers use synchronous reset only (FIX LSQ-006) to avoid BRAM inference issues.

**Mathematical Formulation (with Worked Example)**

```
match[i] = valid[i] AND addr_valid[i] AND data_valid[i]
           AND (addr[i] == load_addr)                                (Eq. B14)

fwd_valid = ( sel < DEPTH ) AND NOT older_unknown AND is_load       (Eq. B15)
```

**Worked Example:**
- A load to address `0x100` executes.
- The LSQ finds an older, committed store to address `0x100` with data `0xDEADBEEF`.
- `fwd_valid = 1` — the load is satisfied from the store queue with data `0xDEADBEEF` in 2 cycles, without touching the L1D Cache.

**Contribution to the Chip**

The LSQ removes the memory-dependence stall on the common store->load case, which is one of the most frequent memory patterns in real code. Store-to-load forwarding turns what would be a multi-cycle memory round-trip into a 2-cycle queue bypass. The vectorised CAM match, 2-cycle forwarding pipeline, and registered drain data keep the LSQ off the critical timing path.

---

### 6.7 L1 Data Cache — `lotus_l1d_cache`

**Module Description**

The L1 Data Cache is a 64-line, direct-mapped, write-back/write-allocate cache with 64-byte (512-bit) cache lines, yielding 4 KB of data storage. It uses a 7-state FSM: `IDLE -> READ_RAM -> COMPARE -> WRITEBACK -> ALLOCATE -> RETRY -> MMIO_SINK`. The MMIO_SINK state (V8.1) safely absorbs MMIO and UART store responses that arrive after a cache-miss redirect, preventing a pipeline hang that would otherwise stall the LSU. The `cpu_resp_data` port is 512 bits wide (V8.0: widened from 64-bit to deliver the full cache line), enabling the AGU/LSQ to extract the relevant 64-bit word directly. On a write hit, the `wmask` is applied byte-wise to the 64-byte cache line using a write-merge mux, preserving all other bytes. On a miss, the cache allocates a new line (evicting and writing back the dirty victim if necessary), and a RETRY state serves the fresh fill data to the original requester (FIX L1D-002). BRAM data writes are reset-free for proper inference (FIX L1D-001: no `if(!rst_n)` branch in the BRAM write `always_ff`). Automatic variables were removed from `always_comb` for Vivado compatibility (FIX L1D-003).

**Mathematical Formulation (with Worked Example)**

```
is_hit = (state == COMPARE) AND valid AND (tag_val == addr.tag)       (Eq. B16)

Write merge: for each byte b in [0..63]:
    line[b] = wmask[b] ? store_data[b] : line[b]
```

**Worked Example:**
- A write hit with `wmask = 0xC0` (binary `1100_0000`) updates only bytes 6 and 7 of the 64-byte line.
- All other 62 bytes remain unchanged.
- If the line is later evicted (on a miss to the same set), the entire 64-byte line (with the 2 updated bytes) is written back to L2.
- On a miss, the RETRY state re-issues the read using `fill_data_q` (the freshly filled line), ensuring the original requester receives the correct data (FIX L1D-002).

**Contribution to the Chip**

The L1D Cache provides single-digit-cycle load-to-use latency on hits, which is the backbone of scalar memory performance. The 512-bit full-line response (V8.0) allows the load data path to extract the correct word from the cache line without a second cache access. The write-merge capability is essential for sub-word stores, and the write-back policy minimises memory bandwidth. The MMIO_SINK state (V8.1) is a critical robustness improvement: it prevents a pipeline hang when stale MMIO/UART store responses arrive after a miss-triggered redirect, ensuring forward progress in all memory-mapped I/O scenarios.

---

### 6.8 L2 Cache — `lotus_l2_cache`

**Module Description**

The L2 Cache is a 16-set, 4-way set-associative, pseudo-LRU (PLRU) unified cache serving both L1I and L1D misses. It has a 4-entry request queue to absorb simultaneous miss bursts, and a 1024-bit DRAM beat that fills two 512-bit cache lines at once (reducing the number of DRAM transactions). All tag, valid, dirty, and data arrays use `(* ram_style = "distributed" *)` (LUTRAM) — zero BRAM is consumed by the L2. A `fill_resp_data` bypass register removes the read-during-write hazard (FIX V7.6) that could return stale data when a fill and a read target the same set in adjacent cycles. The PLRU replacement tree uses 3 bits per set to track access order across the 4 ways.

**Mathematical Formulation (with Worked Example)**

PLRU tree uses 3 bits (t2, t1, t0) per set to track replacement order:

```
Access way0 -> update {t2,0,0}
Access way1 -> update {t2,1,0}
Access way2 -> update {0,t1,1}
Access way3 -> update {1,t1,1}                                        (Eq. B17)

evict = t2 ? (t0 ? 3 : 2) : (t1 ? 1 : 0)                         (Eq. B18)
```

**Worked Example:**
- PLRU tree bits = `3'b011` (t2=0, t1=1, t0=1).
- Cache miss -> need to evict a line.
- `evict = t2 ? ... : (t1 ? 1 : 0) = (0) ? ... : (1 ? 1 : 0) = 1`.
- Way 1 is evicted, and the new line is placed in way 1.

**Contribution to the Chip**

The L2 Cache catches L1 misses for both instruction and data streams, cutting DRAM traffic substantially. The LUTRAM-only implementation (zero BRAM) is a deliberate choice to reserve BRAM resources for the L1I and L1D data arrays. The 1024-bit DRAM beat means each DRAM transaction fills two cache lines, halving the number of DRAM round-trips needed during cache warmup or streaming access patterns.

---

### 6.9 Stride Prefetcher — `lotus_prefetcher`

**Module Description**

The Stride Prefetcher is a 16-entry Reference-Prediction Table (RPT) keyed by a PC hash. It monitors load addresses and detects stride patterns (constant-distance accesses). When a repeated stride is detected with confidence >= 2, it pushes up to 4 prefetch addresses into a 4-deep prefetch queue (`pf_fifo_4deep`). These prefetch requests are sent to the L2 cache ahead of the demand miss, hiding the memory latency. FIX V1.6 resolved a multi-driven-net issue in the FIFO logic by consolidating all tail-pointer updates into a single `case (tail)` block.

**Mathematical Formulation (with Worked Example)**

```
stride = addr - prev_addr                                             (Eq. B19)

if stride == stored_stride AND confidence >= 2:
    push (addr + k * stride) for k = 1..4                             (Eq. B20)
```

**Worked Example:**
- Load sequence: `0x100, 0x140, 0x180`.
- After the second access: `stride = 0x140 - 0x100 = 0x40`, confidence = 1.
- After the third access: `stride = 0x180 - 0x140 = 0x40` (matches stored), confidence = 2.
- Prefetch issued: `0x1C0, 0x200, 0x240, 0x280` (4 prefetches ahead).

**Contribution to the Chip**

The Stride Prefetcher hides sequential and streaming memory latency before the demand miss occurs. For array traversals, matrix operations, and other regular access patterns (which dominate scientific computing and AI workloads), the prefetcher can eliminate a significant fraction of L2/DRAM misses. This is particularly valuable for the tensor engine, which streams weight and activation data through the memory hierarchy.

---

### 6.10 Reorder Buffer — `lotus_rob_masterpiece`

**Module Description**

The Reorder Buffer (ROB) is a 32-entry in-order retirement structure that enforces the sequential ISA contract at the exit of the out-of-order machine. It supports 4-wide dispatch (4 new entries per cycle) and 4-wide commit (4 retired entries per cycle). The payload is stored in banked distributed-RAM (4 banks of 8 entries, `(* ram_style = "distributed" *)`), not flip-flops, saving thousands of LUTs. CDB inputs are registered (FIX V7.7) to break a critical timing path from the execution units through the CDB into the ROB's completion tracking logic — the CDB writeback now uses `rob_valid` from the registered pipeline stage instead of the combinational next-state value. The ROB supports exception handling: on exception, it redirects the PC to `mtvec` and provides the exception cause and value through the CSRs.

**Mathematical Formulation (with Worked Example)**

```
occ' = occ + disp_cnt - retire_cnt                                     (Eq. B21)

commit_valid[i] = rob_valid[head+i] AND completed[head+i]   (in order)  (Eq. B22)
```

**Worked Example:**
- `occ = 30` (30 in-flight instructions), dispatch 2 new entries, retire 4 completed entries.
- `occ' = 30 + 2 - 4 = 28`.
- The head pointer advances by 4, freeing 4 ROB entries.
- Commit is valid only for contiguous completed entries starting from the head — if entry `head+0` is not completed, no entries are committed (in-order guarantee).

**Contribution to the Chip**

The ROB enforces the sequential ISA contract — it ensures that instructions retire in program order even though they executed out of order. The registered CDB path (FIX V7.7) was a significant timing improvement, and the banked distributed-RAM payload saves thousands of LUTs compared to a flip-flop-based implementation.

---

### 6.11 Tensor Engine — `lotus_tensor_engine`

**Module Description**

The Tensor Engine is the AI accelerator's orchestration unit. It manages a complete 8x8 matrix multiply operation through a 6 operational-state FSM (`S_IDLE -> S_MEM_REQ -> S_MEM_WAIT -> S_FEED -> S_DRAIN -> S_WB`) plus a safety default (`S_ILLEGAL`). In the MEM_REQ/MEM_WAIT states, the engine requests matrix A (activations) and matrix B (weights) from memory through the tensor memory arbiter. In the FEED state, 8 rows of matrix A (and the corresponding columns of B, via the outer-product broadcast) are fed into the systolic array over 8 cycles. In the DRAIN state, the 8x8 output matrix is drained over 24 cycles as each column completes its partial sums. In the WB (Write-Back) state, all 64 results are written to the Physical Register File over the CDB with valid/ready backpressure, using `tensor_cdb_p_dest = dest_base + wb_idx`. The CDB writeback is fully internal to `lotus_omni_core_top_v2` (the tensor CDB ports are not exposed at the AXI4 wrapper level, FIX WRAP-TENSOR-001). The engine is precision-aware: BF16 matrices require 2 cache lines per row (128 bytes), while INT8 matrices require 1 line (64 bytes). v3.0.0 includes a dataflow alignment fix that pairs with PE V10.0 and array V5.0/V2.0 to ensure correct outer-product accumulation. Formal verification is provided by the tensor memory arbiter (12 SVA assertions + 7 cover points); the tensor engine itself is verified through self-checking simulation.

**Mathematical Formulation (with Worked Example)**

```
C[i][j] = SUM_{k=0..7} A[i][k] * B[k][j]    (32-bit accumulate, saturated)   (Eq. T1)

tensor_cdb_p_dest = dest_base + wb_idx                                   (Eq. T2)
```

**Worked Example:**
- BF16 matrix multiply with all weights = 2.0 and all activations = 3.0.
- Each element of C: `C[i][j] = SUM_{k=0..7} 2.0 * 3.0 = 8 * 6.0 = 48.0`.
- After the DRAIN phase, all 64 elements of C are written to PRF entries starting at `dest_base`.

**Contribution to the Chip**

The Tensor Engine delivers AI inference throughput (64 MACs/cycle peak) without disturbing scalar IPC, thanks to the background memory arbiter that gives CPU requests strict priority. The FSM-based orchestration means the tensor operation is a single instruction from the CPU's perspective — the scalar pipeline issues a tensor opcode and continues executing other instructions while the tensor engine works in the background.

---

### 6.12 Systolic Arrays & Processing Elements — BF16 / INT8

**Module Description**

The systolic arrays are the computational fabric of the tensor accelerator. Lotus Omni has two 8x8 **outer-product broadcast** systolic arrays: one for BF16 (bfloat16) and one for INT8 quantised inference.

**Outer-Product Broadcast Dataflow (V5.1 / V2.0):** In each feed cycle, the input activation row `a_in[i]` is broadcast to all 8 PEs in row i, and the input weight column `b_in[j]` is broadcast to all 8 PEs in column j. Each PE(i,j) independently computes `a_in[i] * b_in[j]` and accumulates the product into its **local accumulator**. Over 8 feed cycles (k=0..7), each PE accumulates `SUM_k A[i][k] * B[k][j]`, computing a complete element of the output matrix C. There is no vertical or horizontal data movement between PEs — the accumulation is entirely local, with no inter-PE dependency chain. The `clear_acc` signal is registered alongside the input data through the same pipeline stages (V5.1 alignment fix), ensuring that the accumulator reset arrives at the PE adder at exactly the same cycle as the k=0 product.

**BF16 Tensor PE (V10.0):** Each BF16 PE is a 3-stage pipeline: Stage 1 registers the input operands (with sign extension to 18-bit) and the `clear_acc` signal; Stage 2 performs the 8x8 multiply (`(* use_dsp = "yes" *)`) and registers the product; Stage 3 performs the local 37-bit accumulate with saturation to INT32 range, and registers the output. The PE uses synchronous reset (no async reset) to enable DSP48 SR packing for area efficiency. Operand isolation gates both inputs to zero when either input is zero, disabling the DSP multiplier to save dynamic power. The `in_acc` port is retained for interface compatibility but is **unused** — the PE maintains its own local `acc_reg` that feeds back into the adder.

**BF16 Multiplier (V4.0, ASIC-Portable):** The standalone BF16 multiplier (`lotus_bf16_mult`) is a 3-stage pipeline: Stage 1 extracts fields and computes exponent sum with overflow/underflow detection (using a 10-bit signed intermediate for safe range checking); Stage 2 performs the 8x8 mantissa multiplication (direct `op_a_mant_reg * op_b_mant_reg`, no FPGA-specific DSP padding or attributes — ASIC tools will automatically select the optimal multiplier topology); Stage 3 normalises and packs the result, handling the product >= 2.0 case by shifting right and incrementing the exponent.

**INT8 Tensor PE (V3.0):** The INT8 PE is a 3-stage pipeline with DSP48E2-ready timing (targeting 2GHz). It supports hardware structured sparsity via a `sparsity_en` input that skips MAC operations when the registered weight input is zero. It uses 33-bit AI saturation logic: if the 33rd bit (sign extension) differs from the 32nd bit, the result is clamped to the nearest INT32 extremum.

**INT8 Systolic Array (V2.0):** Converted from wavefront to outer-product broadcast (matching the BF16 V5.1 architecture). The `clear_acc` signal is registered alongside the data, and the `in_acc` port of each `lotus_tensor_pe` is fed back from its own `out_acc`, creating local accumulation.

**Mathematical Formulation (with Worked Example)**

```
BF16: value = (-1)^s * 2^(e - 127) * (1.m)
e_result = e_a + e_b - 127                                              (Eq. T3)

e_result >= 255 -> +/-Inf
    e_result <= 0   -> +/-0
    product >= 2    -> shift right, e + 1                                 (Eq. T4)

Outer-product: PE(i,j) acc += a_in[i] * b_in[j]  each cycle k=0..7     (Eq. T5)

INT8 saturation:
    if add[32] != add[31] -> clamp to +(2^31 - 1) / -(2^31)             (Eq. T6)
```

**Worked Example (Outer-Product Broadcast):**
- Feed cycle k=0: `a_in = [1, 2, 3, 4, 5, 6, 7, 8]`, `b_in = [10, 20, 30, 40, 50, 60, 70, 80]`.
- `clear_acc = 1` (first cycle of a new MAC operation).
- PE(0,0): `acc = 0 + 1*10 = 10`. PE(0,1): `acc = 0 + 1*20 = 20`. PE(1,0): `acc = 0 + 2*10 = 20`.
- Feed cycle k=1: `a_in = [9, 10, ...]`, `b_in = [11, 21, ...]`.
- PE(0,0): `acc = 10 + 9*11 = 109`. PE(0,1): `acc = 20 + 9*21 = 209`.
- After 8 feed cycles, each PE holds its final C[i][j] value.

**Contribution to the Chip**

The systolic arrays are the compute fabric for AI workloads. Each 8x8 array delivers 64 MACs per cycle, and the BF16 PE maps to a single DSP48E1 slice — 64 DSPs for 64 PEs. The outer-product broadcast dataflow eliminates inter-PE data dependencies, simplifying the control logic and timing closure compared to a wavefront approach. The dual-precision support (BF16 for high-accuracy inference, INT8 for throughput-optimised inference) makes the design flexible for different model requirements. The local accumulation pattern (V10.0 / V2.0) fixed a dataflow alignment bug where `clear_acc` arrived one cycle early relative to the first product.

---

### 6.13 Structured Sparsity Engine — `lotus_sparsity_engine_v3`

**Module Description**

The Structured Sparsity Engine implements 2:4 structured sparsity (the same format used in NVIDIA Ampere/Hopper GPUs). For every group of 4 weight values, the two with the largest absolute magnitude are retained and the other two are zeroed. A 3-bit metadata value encodes which two positions were kept (6 possible combinations out of C(4,2) = 6, perfectly fitting in 3 bits). This halves the tensor bandwidth (only 2 of 4 weights need to be loaded from memory) and doubles effective throughput (zero-valued weights skip MAC operations entirely). A backpressure hold (FIX SPARSE-HS-001) prevents metadata overwrite during pipeline stalls. The engine processes 16 groups (64 elements) per cycle, producing 32 non-zero value/metadata pairs.

**Mathematical Formulation (with Worked Example)**

For each group `g` of 4 weights:

```
{sel0, sel1} = argmax2 |v[i]|  for i = 0..3
meta = encode(sel0, sel1)  in {000, 001, 010, 011, 100, 101}          (Eq. T7)
```

**Worked Example:**
- Weight group: `[3, -9, 1, 7]`.
- Absolute values: `[3, 9, 1, 7]`.
- Two largest: `-9` (index 1) and `7` (index 3).
- `sel0 = 1, sel1 = 3`, `meta = encode(1,3) = 100` (binary).
- The systolic array receives only 2 weights (`-9, 7`) with metadata `100`, skipping the MAC for the zeroed positions.

**Contribution to the Chip**

The Sparsity Engine halves tensor memory bandwidth and skips zero MACs, effectively doubling throughput on sparse models. Since many trained neural networks can be pruned to 2:4 sparsity with minimal accuracy loss (typically <1% degradation), this feature provides a near-free 2x throughput improvement.

---

### 6.14 Tensor Memory Arbiter — `lotus_tensor_mem_arbiter`

**Module Description**

The Tensor Memory Arbiter controls access to the L1D Cache port between the CPU (scalar pipeline) and the Tensor Engine. It implements strict CPU-priority arbitration with a single `grant_is_tensor` flag: if the CPU and tensor engine both request memory in the same cycle, the CPU always wins (`grant_is_tensor = 0`). The tensor request is serviced on the next cycle when the CPU is idle. An outstanding-transaction guard drops spurious or late responses (fail-safe design). The `RESET_SAFE` parameter controls the power-up grant state (CPU by default). FIX v2.1.0 resolved a multi-driven net (Synth 8-6859) by consolidating all assignments into a single `assign` per signal with the outstanding guard included inline. 12 formal SystemVerilog assertions (plus 7 cover points) verify protocol correctness under all arbitration scenarios.

**Mathematical Formulation (with Worked Example)**

```
grant_is_tensor = NOT cpu_req_valid AND tensor_req_valid AND NOT outstanding   (Eq. T8)

l1d_req_valid = (cpu_req_valid OR tensor_req_valid) AND NOT outstanding     (Eq. T9)
```

**Worked Example:**
- Cycle N: CPU issues a load, tensor engine issues a weight fetch.
- `grant_is_tensor = NOT 1 AND 1 AND NOT 0 = 0` — CPU wins.
- Cycle N+1: CPU is idle, tensor request is still pending.
- `grant_is_tensor = NOT 0 AND 1 AND NOT 0 = 1` — tensor engine is serviced.

**Contribution to the Chip**

The Tensor Memory Arbiter lets the tensor engine stream data through the memory hierarchy without degrading the scalar pipeline's load-to-use latency. The strict CPU-priority scheme ensures that the scalar IPC is never sacrificed for tensor throughput. The formal assertions (12 SVA checks) provide mathematical proof that the arbitration protocol cannot deadlock or deliver stale data.

---

### 6.15 NoC Router — `lotus_noc_router_masterpiece`

**Module Description**

The Network-on-Chip (NoC) Router is a 5-port (Local, North, South, East, West) XY-routing switch with per-port LUTRAM FIFO buffers (`noc_fifo_storage`, 4-deep) and round-robin arbitration for output port contention. It supports HEAD/BODY/TAIL flit-based packet transmission, where the HEAD flit carries the destination coordinates and route computation, BODY flits carry the payload, and the TAIL flit signals the end of the packet and releases the output port. FIX NOC-P0-001 resolved Synth 8-7137 set/reset priority warnings by ensuring all set logic is nested inside `else` blocks, giving reset unconditional priority over set operations in all `always_ff` blocks.

**Mathematical Formulation (with Worked Example)**

XY dimension-ordered routing:

```
dx > x_dest  ->  route EAST
dx < x_dest  ->  route WEST
dx == x_dest AND dy > y_dest  ->  route NORTH
dy < y_dest  ->  route SOUTH
else          ->  route LOCAL (destination reached)                    (Eq. N1)
```

**Worked Example:**
- Router at position `(1,1)`, flit destined for `(3,1)`.
- `dx = 3 - 1 = 2 > 0` -> route EAST.
- After routing east to `(2,1)`: `dx = 3 - 2 = 1 > 0` -> route EAST again.
- After routing east to `(3,1)`: `dx = 3 - 3 = 0, dy = 1 - 1 = 0` -> route LOCAL (arrived).

**Contribution to the Chip**

The NoC Router scales the design toward multi-core and multi-tile topologies. The XY routing algorithm is deadlock-free (no cycles in the dependency graph) and the per-port FIFOs absorb burst traffic without dropping packets. FIX NOC-P0-001 eliminated all Synth 8-7137 warnings by ensuring proper reset/set priority, which is essential for reliable FPGA synthesis.

---

### 6.16 Congestion-Aware Flow Gates & Throttle — `congestion_aware_flow_gate` et al.

**Module Description**

The congestion control subsystem consists of three modules:

1. **`congestion_aware_flow_gate`** (V2.2): A credit-based valid/ready flow gate with a 4-deep LUTRAM skid FIFO (`(* ram_style = "distributed" *)`, changed from "block" in V2.2 for correct shallow-FIFO inference), a credit counter, a throttle counter, and a duty-cycle monitor. Upstream readiness requires: gate enabled, FIFO not full, credits below max outstanding, and throttle tick active. V2.2 changed all `always_ff` blocks from asynchronous to synchronous reset, enabling Vivado to pack the `* 100` multiplication into a DSP48E1 slice.

2. **`flow_gate_array`**: Instantiates `NUM_STAGES` (default 4) parallel flow gates, each with independent enable and status. Used at the LSU, DRAM, NoC, and tensor boundaries.

3. **`global_throttle_controller`**: A PID-like proportional controller that monitors aggregate utilisation and adjusts the global throttle limit. The utilisation percentage is computed by a 32-cycle shift-subtract sequential divider (V2.2: replaced a combinational divider that was a "timing bomb" — the 32-cycle version uses only 1 LUT and 1 FF per cycle, compared to a 34-CARRY4 chain for a combinational divider). The off-by-one fix corrected the cycle count from 33 to 32 to prevent erroneous quotient doubling. The remainder is properly updated even when no subtraction occurs.

**Mathematical Formulation (with Worked Example)**

```
credits' = credits + consumed - freed                                 (Eq. C1)

up_ready = enable AND NOT full AND (credits < max)
           AND throttle_tick                                              (Eq. C2)

Sequential divider (32-cycle shift-subtract):
  util% = (usage * 100) / capacity                                         (Eq. C3)
```

**Worked Example:**
- `usage = 6700` cycles active, `capacity = 13400` total cycles.
- The 32-cycle shift-subtract divider computes: `6700 / 13400 * 100 = 50%`.
- At 50% utilisation, the throttle is relaxed (full bandwidth available).
- If utilisation exceeds 80%, the PID controller reduces `throttle_tick` frequency, throttling injection rate.

**Contribution to the Chip**

The congestion control subsystem provides datacentre-style Quality-of-Service (QoS) on an FPGA budget. The credit-based protocol prevents buffer overflow at the source, and the PID-like throttle provides proportional fairness between the scalar and tensor traffic streams. V2.2's sequential divider and synchronous reset changes were essential for both timing closure and correct DSP packing.

---

### 6.17 CSR & PMU — `lotus_csr`, `lotus_pmu`

**Module Description**

**CSR (V1.0):** Implements RISC-V Machine-mode CSRs: `mstatus` (0x300, default MPP=11 for M-mode), `misa` (0x301, RV64I+M+A+F+D+C+X hardwired), `mtvec` (0x305, default `0x8000_0000`), `mepc` (0x341), `mcause` (0x342), `mtval` (0x343), and `mhartid` (0xF14). Custom CSRs: `tensor_ctrl` (0x800, bits [1:0]=precision mode, bit [2]=tensor_en, default BF16+enabled = 0x05), `sparsity_ctrl` (0x801, bit [0]=sparsity_en, default enabled = 0x01). FENCE/FENCE.I instruction support (HIGH-014): `fence_complete` and `fence_i_complete` output signals track fence completion, with custom read-only CSRs at 0x7C0 and 0x7C1 for software polling. CSR operations support write (01), set-bits (10), and clear-bits (11). The `mstatus` default value `0x1800` sets MPP to Machine mode (11).

**PMU:** Provides 13 hardware counters: clock cycles, committed instructions, L1I hits, L1I misses, L1D hits, L1D misses, L2 hits, L2 misses, branch mispredicts, fetch stalls, issue stalls, tensor cycles, and sparsity skips. All counters have overflow guards. The IPC (Instructions Per Cycle) is approximated using a pipelined shift-based fixed-point calculation (OPT-001, PMU-TIMING-01): `IPC = (commit_total << 10) / cycles`, where `commit_total` is registered for timing.

**Mathematical Formulation (with Worked Example)**

```
IPC = (commit_total << 10) / cycles     (fixed-point * 1024)           (Eq. P1)

Real IPC = IPC_value / 1024.0
```

**Worked Example:**
- `commit_total = 4000` instructions, `cycles = 2000`.
- `IPC = (4000 << 10) / 2000 = (4000 * 1024) / 2000 = 4,096,000 / 2000 = 2048`.
- `Real IPC = 2048 / 1024 = 2.0` (the processor is executing 2 instructions per cycle on average).

**Contribution to the Chip**

The CSR/PMU subsystem makes the design observable and software-controllable — essential for real hardware bring-up (reading `mcause` to diagnose exceptions, writing `mtvec` to set up trap handlers) and for performance engineering (using PMU counters to measure IPC, cache hit rates, and mispredict rates). The FENCE/FENCE.I support (V1.0) enables memory ordering instructions required by the RISC-V specification, with completion signals that the pipeline can use to gate subsequent memory operations.

---

## 7. Achievements

- **Timing Closure:** Worst Negative Slack improved from **-7.019 ns to +0.252 ns** (0 out of 166,090 failing endpoints) at 80 MHz OOC on the slowest Artix-7 speed grade, achieved through approximately 15 targeted pipeline-register and arithmetic-decoupling fixes across 6 major timing-closure iterations. The subsequent tensor-subsystem integration (outer-product systolic arrays + Tensor Engine v3.0.0) and the L1D V8.0 full-line datapath widening added ~7,300 endpoints yet held timing positive. A further round of module updates (BF16 multiplier, congestion control refactor, L1I V4.2 simulation fix, IFU deadlock fix) added ~9,000 more endpoints, and timing **improved to +0.252 ns** — every addition was absorbed with positive slack to spare.

- **Full-Core Functional Simulation (self-checking, PASS 64/64):** The tensor MATMUL engine and the supporting pipeline stages run concurrently in simulation (`tb_lotus_core_demo3`). A self-checking testbench loads weights = 2 and activations = 3, runs a full 8×8 MATMUL through the outer-product systolic array, and verifies that **all 64 PRF results equal the exact expected value 2×3×8 = 48 (0x30)** — reporting **PASS: 64/64**. This demonstrates end-to-end data integrity from memory through the systolic array back to the register file, with the accumulator-clear alignment (V10.0 PE / V5.1 array / v3.0.0 engine) confirmed correct.

- **30 Source Files / 35 Instantiated Modules:** All 30 SystemVerilog source files (mapping to 31 architecturally distinct units plus 4 internal submodules: `decoder_diq_bank`, `rs_payload_bank`, `pf_fifo_4deep`,`noc_fifo_storage`) have been individually unit-tested, integrated into the core, and verified through both behavioural simulation and post-synthesis static timing analysis.

- **Formal Verification:** 12 SVA assertions plus 7 cover points on the tensor memory arbiter protocol provide formal mathematical guarantees of correctness for the memory-arbitration handshake. The tensor engine is verified through self-checking simulation (PASS 64/64) rather than SVA.

- **Scalar Bring-Up (coretest) Debug Campaign — in progress:**
  The scalar bring-up workload was renamed from "coremark" to **coretest** —
  an 8-instruction UART store test (`lui` + 3×`addi` + 3×`sb` + `nop`
  targeting a UART at 0x1000_0000) — because the full CoreMark binary is not
  yet loaded; the name honestly reflects the workload actually executed.
  Across the campaign, in-order commits progressed **0 → 2 → 4 → 7 → 15** as
  each blocking bug was root-caused and fixed:

  | # | Bug (root cause) | Fix (RTL version) | Effect |
  |---|------------------|-------------------|--------|
  | 1 | ALU CDB rob_idx timing mismatch | registered rob_idx (top) | +2 commits |
  | 2 | Load p_dest timing mismatch | pipelined load p_dest (top) | +2 commits |
  | 3 | RS occupancy underflow | pure-arithmetic occupancy, no clamps (RS V5.6) | stable occupancy |
  | 4 | Stores never complete in ROB | `agu_completes` wired to CDB port 3 (top V10.8) | stores complete |
  | 5 | `commit_is_store` always 0 | opcode-based is_store (ROB V8.3) | stores commit |
  | 6 | Conditional branches never complete | all branches assert `cdb_valid` (BR V2.1) | branches commit |
  | 7 | x0-target ALU ops never complete | removed `p_dest!=0` gate; X-safe `!==` (ALU V4.3) | NOPs commit |
  | 8 | Illegal-CSR exception loop | added cycle/time/instret/mcycle/minstret (CSR V1.1) | no trap loop |
  | 9 | RS slots permanently lost | clear `rs_issued`/`rs_reserved` on dispatch (RS V5.8) | RS reusable |
  | 10 | PRF stale read (AGU base = 0) | `src*_is_cdb` tracking + combinational PRF rd-addr (RS V5.8); same-cycle write-first bypass (PRF V4.2) | correct base address |
  | 11 | LSQ draining stores with addr=0 | `addr_valid`/`data_valid` gating (LSQ V3.8); stores-only SQ allocation (top V11.1) | safe drain |
  | 12 | L1D hang on MMIO store | `MMIO_SINK` state (L1D V8.1) | UART store absorbed |

  **Current state:** all 8 coretest instructions fetch, decode, rename and
  dispatch; stores issue with the correct effective address (0x1000_0000).
  Remaining work: closing the store-commit → LSQ-drain → L1D `MMIO_SINK` →
  UART-observe handshake so the test self-passes ("A B D").

---

## 8. Development Timeline

The Lotus Omni project was developed by a single self-taught engineer, with AI pair-programming assistance. Active RTL development spanned approximately **nine months** of focused engineering work, from the first lines of processor RTL to timing-closed silicon-ready design.

| Period | Milestone |
|---|---|
| **Nov 2025** | Concept definition, RISC-V ISA study, initial architecture design |
| **Nov - Dec 2025** | Processing Element (PE) design, systolic array implementation, unit testbenches for all tensor modules |
| **Dec 2025 - Jan 2026** | Front-end pipeline: IFU, L1I Cache, TAGE predictor, Decoder, Renamer |
| **Jan - Feb 2026** | Back-end pipeline: Reservation Stations, PRF, ALU, Branch Exec, AGU, LSQ, ROB |
| **Feb - Mar 2026** | Memory hierarchy: L1D Cache, L2 Cache, Stride Prefetcher, DRAM Gate |
| **Mar - Apr 2026** | Tensor subsystem: Tensor Engine FSM, BF16/INT8 systolic arrays, Sparsity Engine, Tensor Memory Arbiter |
| **Apr - May 2026** | On-chip interconnect: NoC Router, Congestion-Aware Flow Gates, PID Throttle |
| **May - Jun 2026** | CSR, PMU, AXI4 Wrapper, top-level integration (`lotus_omni_core_top_v2`) |
| **Jul 2026** | Core integration, Tensor Engine v2/v3, **timing-closure campaign** (6 iterations, ~15 targeted fixes) |
| **Aug 2026** | Full-core simulation demos, documentation, publication and major bug fixing |

**Total Development Time: ~9 months (solo, with AI pair-programming assistance)**

**Tools & Assistance Used:**
- Xilinx Vivado (synthesis, implementation, timing analysis)
- SystemVerilog / Verilog for RTL design
- AI pair-programming assistance for code review, debugging, and documentation (disclosed transparently)
- GTKWave for waveform analysis
- RISC-V ISA specification (Volume 1: Unprivileged ISA)

---

## 9. Results Progress

The timing-closure campaign progressed through 6 major iterations, each targeting the worst remaining critical path. The table below shows the Worst Negative Slack (WNS), number of failing endpoints, and the key fix applied at each stage.

| Stage | WNS (ns) | Failing Endpoints | Key Fix |
|---|---|---|---|
| Baseline | -7.019 | 37,499 | PRF unregistered arbitration (combinational priority mux) |
| +PRF fix | -4.304 | — | Registered one-hot grant arbitration |
| +ALU pipeline | -3.345 | 9,555 | EX1/EX2 pipeline split (register the operands) |
| +Renamer/TAGE | -2.282 | 7,052 | Renamer output registration, pipelined TAGE training |
| +RS clamps | -1.739 | 2,102 | Pure-arithmetic occupancy (remove comparator clamps) |
| +ROB/PMU/LSQ | -0.952 | 2,102 | CDB->ROB registered path, counter pipelining |
| **Final @80 MHz** | **+0.109** | **0** | Clock period relaxed to 12.5 ns (80 MHz target) |
| +Tensor + L1D full-line | **+0.141** | **0** | Outer-product systolic arrays (V10.0/V5.1/V2.0), Tensor Engine v3.0.0, L1D V8.0 512-bit full-line response — +7,300 endpoints absorbed (157,103 total) |
| +BF16 mult + NoC refactor + fixes | **+0.252** | **0** | `lotus_bf16_mult` V4.0 3-stage pipeline, `flow_gate_array` + `global_throttle_controller` refactor, L1I V4.2 X-state fix, IFU V1.1 deadlock fix — +8,987 endpoints absorbed (166,090 total) |

**FPGA Resource Utilisation (post-route, Vivado 2025.2, xc7a200t):**
| Resource | Utilised | Available | Util% | Notes |
|---|---|---|---|---|
| Slice LUTs | 61,546 | 134,600 | 45.73% | 54,640 as logic + 6,906 as distributed RAM (LUTRAM) |
| Slice Registers | 40,250 | 269,200 | 14.95% | 0 latches — all FDRE/FDCE/FDSE/FDPE flip-flops |
| Block RAM Tile | 17 | 365 | 4.66% | 16× RAMB36E1 + 2× RAMB18E1 (L1I + L1D data/tag arrays only; L2 is LUTRAM-only) |
| DSP48E1 | 64 | 740 | 8.65% | One per BF16 systolic-array PE (64 PEs), DSP48 SR packing via synchronous resets |
| F7 Muxes | 5,748 | 67,300 | 8.54% | Wide muxes from RS select, PRF read ports, and tensor datapath |
| F8 Muxes | 2,422 | 33,650 | 7.20% | Cross-slice muxes for address/data steering in LSQ and RS |

---

## 10. Future Plan

1. **Close the coretest UART handshake (in progress):** complete the
   store-commit → LSQ-drain → L1D `MMIO_SINK` → UART path so the 8-instruction
   coretest prints "A B D" and self-passes.

2. **Full CoreMark binary:** once coretest passes, load the real CoreMark RV64
   binary and run the full benchmark with PMU-based IPC measurement.

3. **RISC-V Compliance Suite:** run the official RISC-V compliance tests and
   implement automated scalar commit-value checking in the testbench.

4. **Physical Board Bring-Up:** build a bitstream-buildable top-level wrapper
   with real DRAM and AXI interconnect; bring up on an Artix-7 board.

5. **Decoder-Driven Tensor Issue:** drive tensor operations from the decoded
   instruction path (rather than testbench injection).

6. **Pipelined Tensor Arbiter & Multi-Outstanding Memory:** pipeline the tensor
   memory arbiter and support multiple outstanding transactions.

7. **2→4-Issue Scaling & Multi-Core:** tune the pipeline for full 4-issue and
   integrate a second core tile over the NoC.

---

## 11. Summary

Lotus Omni is a complete, timing-closed, superscalar out-of-order RISC-V processor with a systolic tensor accelerator, structured sparsity, TAGE branch prediction, a three-level memory hierarchy, and a congestion-aware Network-on-Chip — built solo over approximately nine months of active RTL development and verified by synthesis, simulation, and a documented timing-closure campaign. All 30 `.sv` source files are implemented, integrated, and completed. The 30 files instantiate 35 modules (31 architecturally distinct units plus 4 internal submodules: `decoder_diq_bank`, `rs_payload_bank`, `pf_fifo_4deep`, `noc_fifo_storage`). The tensor accelerator uses outer-product broadcast systolic arrays with local accumulation for both BF16 and INT8 precisions. The mathematics presented for each module (Eqs. F1–F14, B1–B22, T1–T9, N1, C1–C3, P1) are the exact functions realised in the RTL. The design targets the AI edge processor class and is ready for FPGA board bring-up, compliance testing, and eventual ASIC tapeout. Scalar bring-up (coretest) is in progress: an 8-instruction UART store test currently reaches 15 in-order commits with stores issuing at the correct effective address; the remaining store-drain/UART handshake is the active debug target (see §7 debug-campaign table).

---

*Sources: RTL source files in `RTL/` directory. Testbenches in `TB/` directory. Timing-closure log: `docs/TIMING_LOG.md`.*
