Sanuka-cmd-net/lotus-omni/screenshots/Reported screenshot/Dataflow Design.png

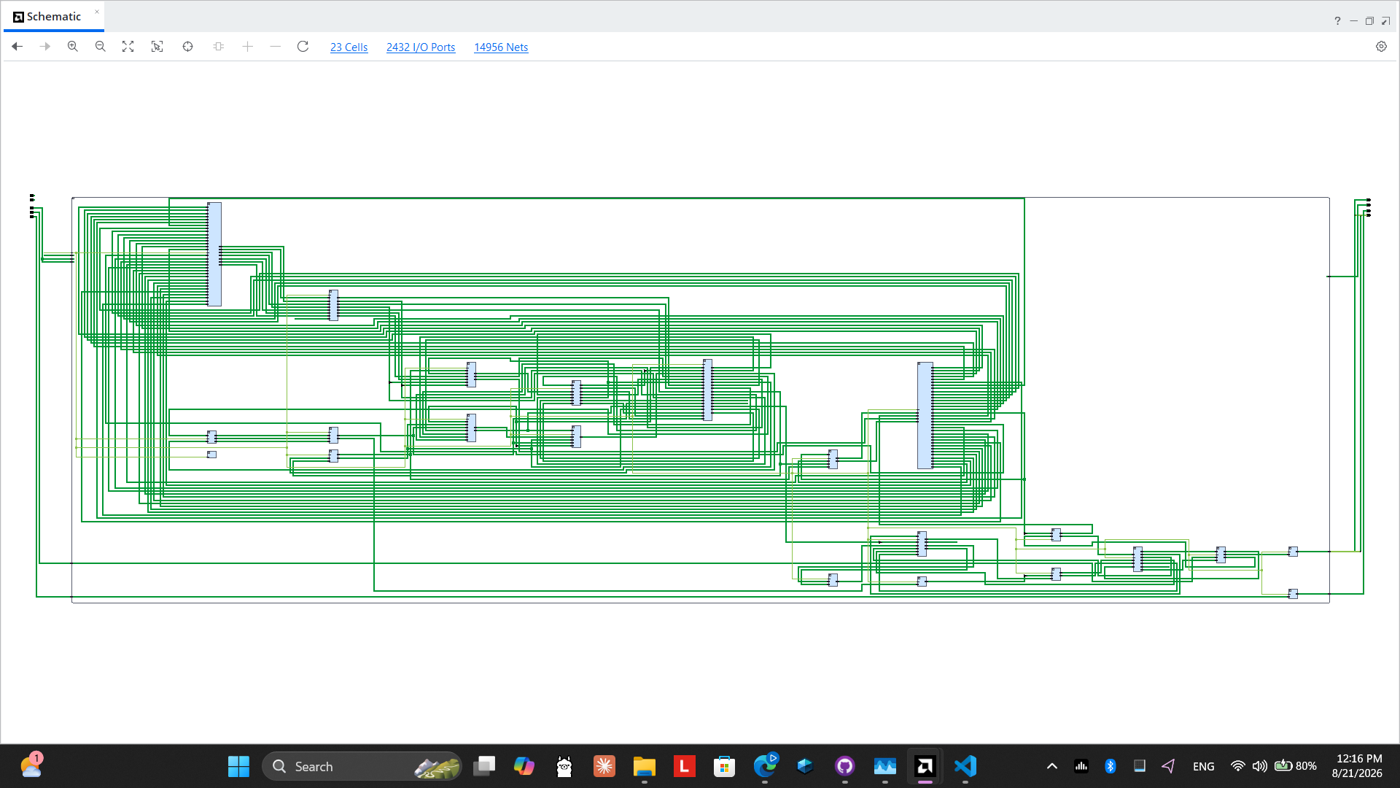
screenshots/Reported screenshot/Dataflow Design.png
