Sanuka-cmd-net/lotus-omni/screenshots/Reported screenshot/Elaboarated Design.png

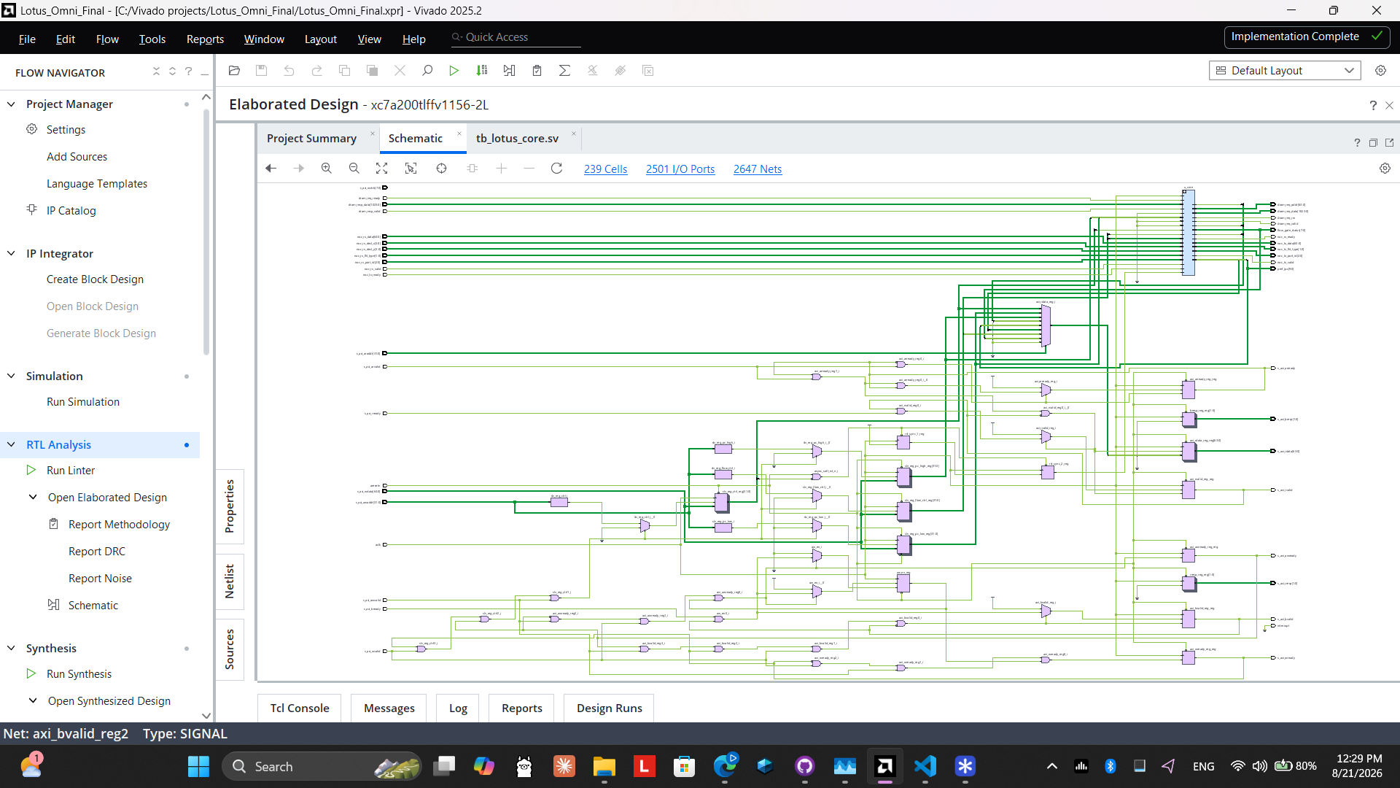
screenshots/Reported screenshot/Elaboarated Design.png
