Sanuka-cmd-net/lotus-omni/screenshots/Reported screenshot/Implemented Schematic.png

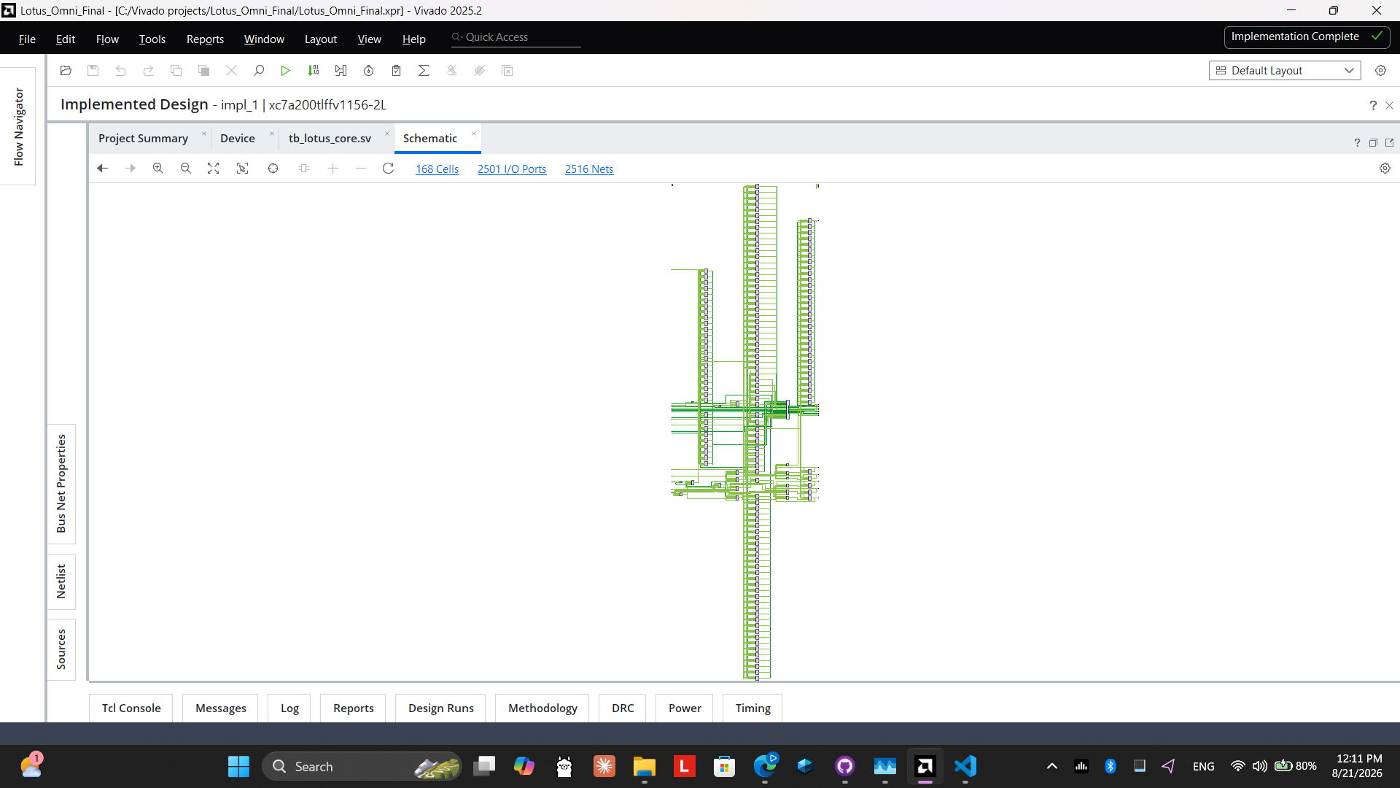
screenshots/Reported screenshot/Implemented Schematic.png
