Sanuka-cmd-net/lotus-omni/screenshots/Reported screenshot/Synthesized Design.png

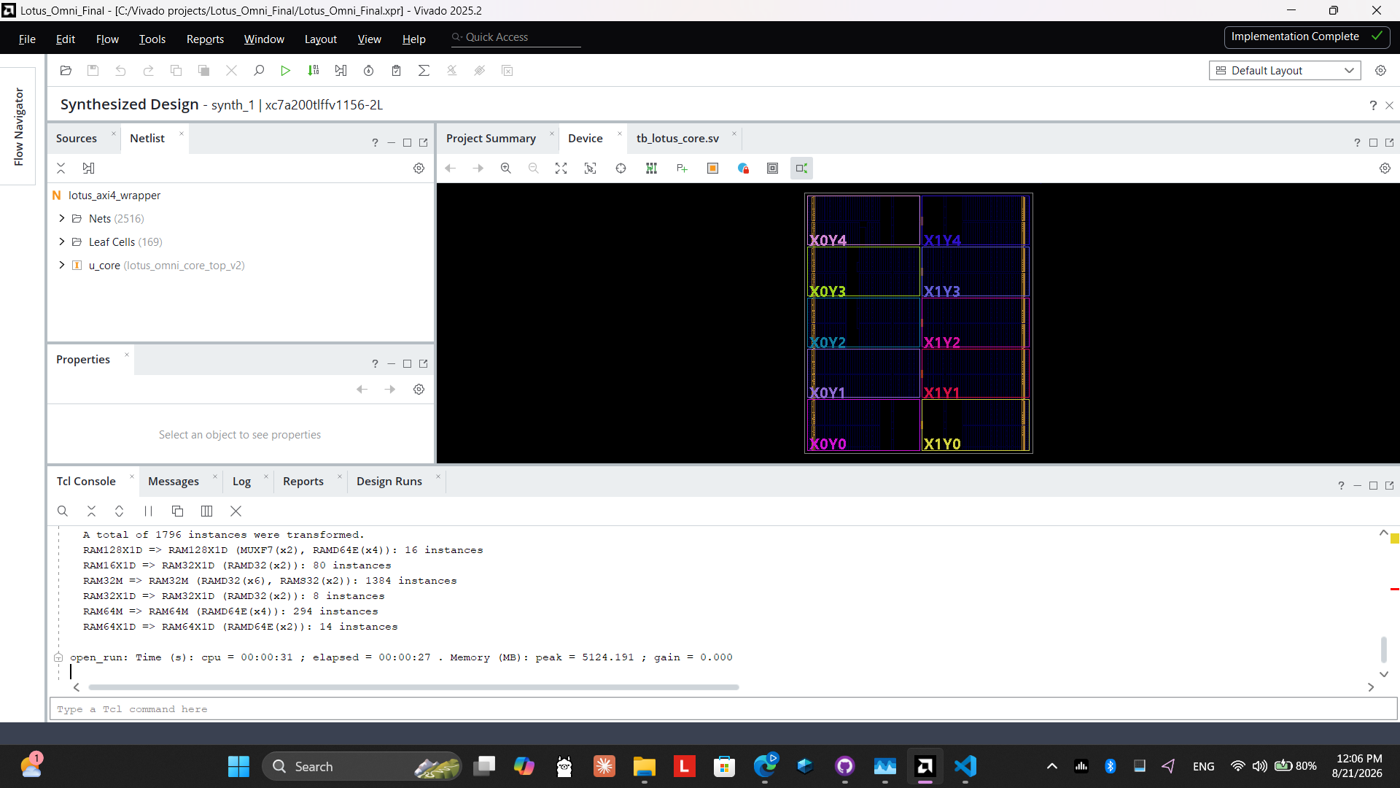
screenshots/Reported screenshot/Synthesized Design.png
