Sanuka-cmd-net/lotus-omni/screenshots/Simulation Screenshots/coretest screenshot 1.png

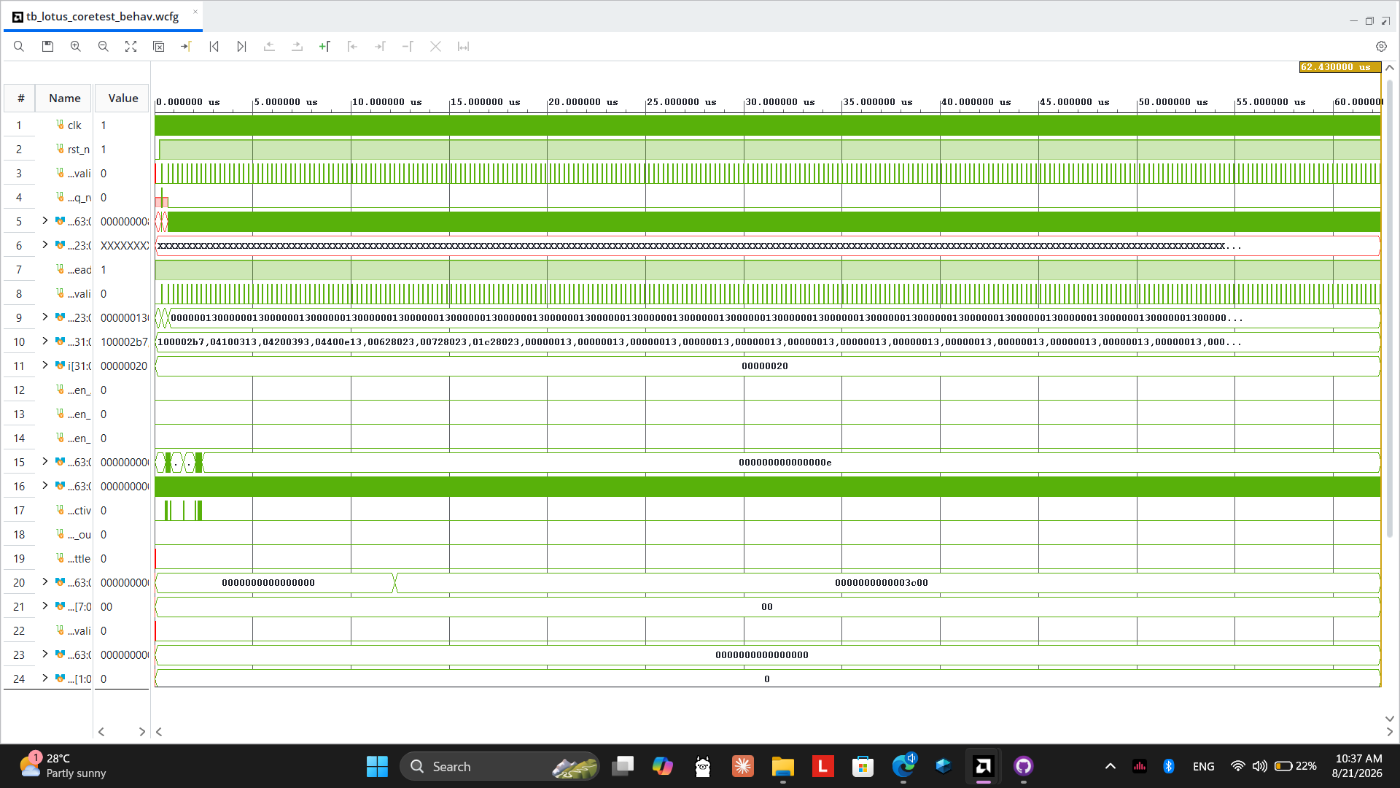
screenshots/Simulation Screenshots/coretest screenshot 1.png
