Sanuka-cmd-net/lotus-omni/screenshots/Simulation Screenshots/coretest screenshot 2.png

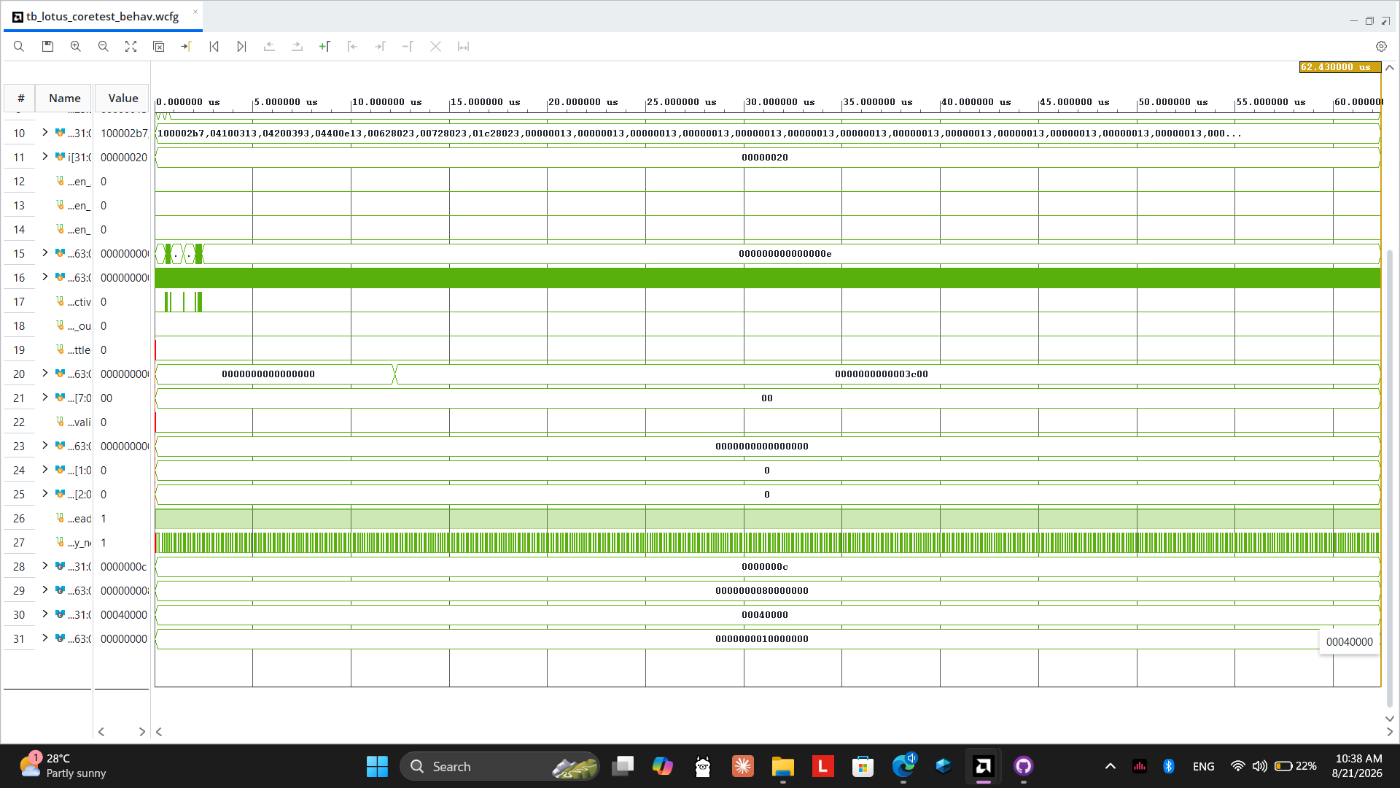
screenshots/Simulation Screenshots/coretest screenshot 2.png
