Sanuka-cmd-net/lotus-omni/screenshots/Simulation Screenshots/Demo 1 Screenshot 1.png

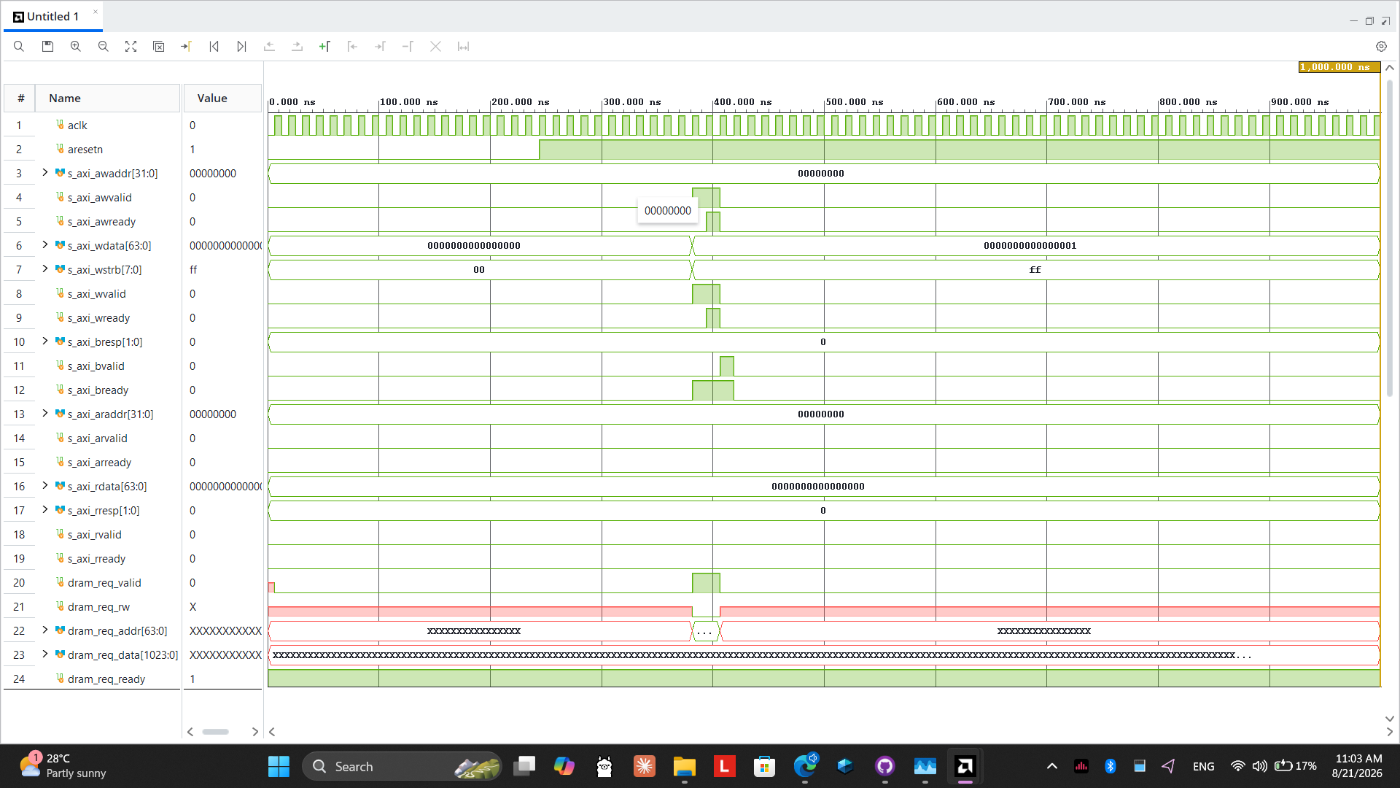
screenshots/Simulation Screenshots/Demo 1 Screenshot 1.png
