Sanuka-cmd-net/lotus-omni/screenshots/Simulation Screenshots/Demo 1 screenshot 2.png

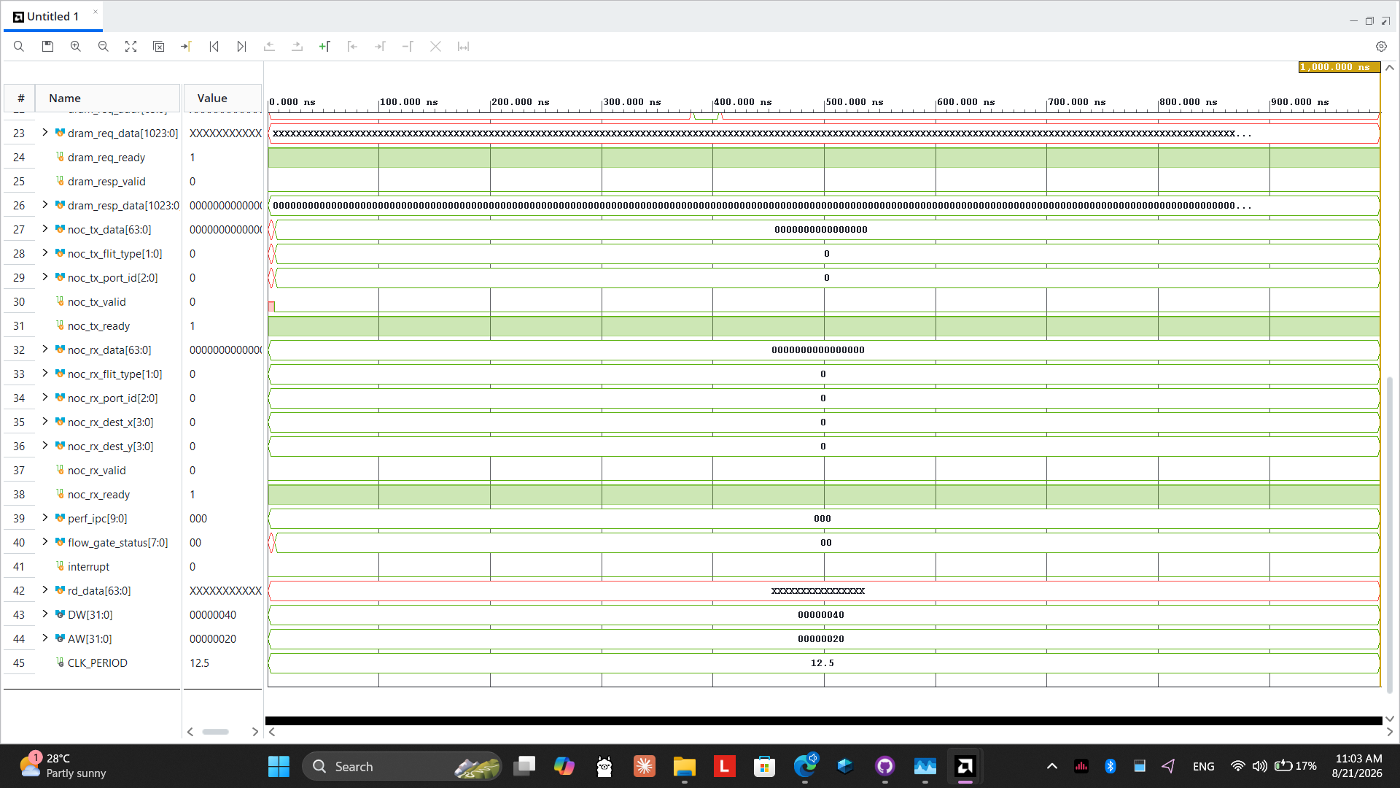
screenshots/Simulation Screenshots/Demo 1 screenshot 2.png
