Sanuka-cmd-net/lotus-omni/screenshots/Simulation Screenshots/Demo 2 sceenshot 1.png

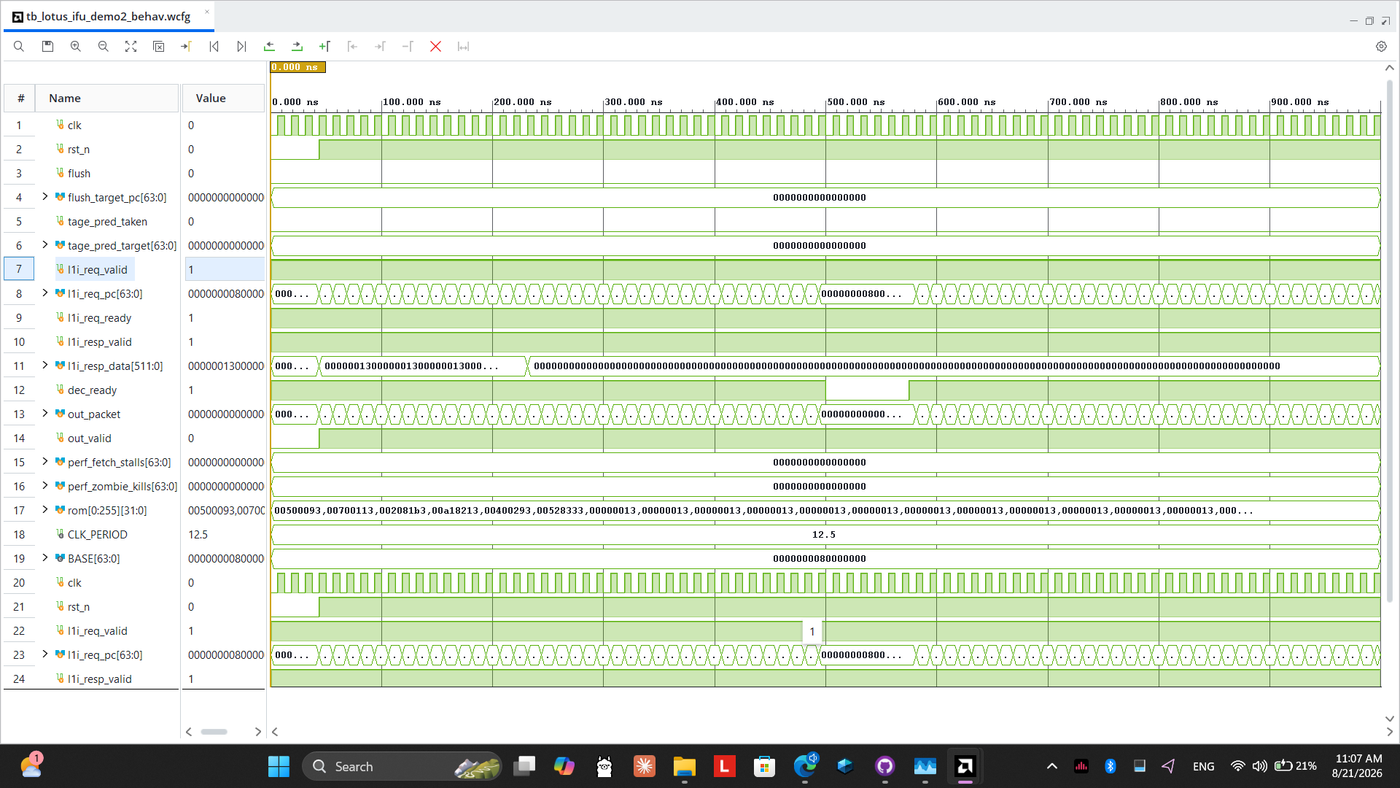
screenshots/Simulation Screenshots/Demo 2 sceenshot 1.png
