Sanuka-cmd-net/lotus-omni/screenshots/Simulation Screenshots/Demo 2 screenshot 2.png

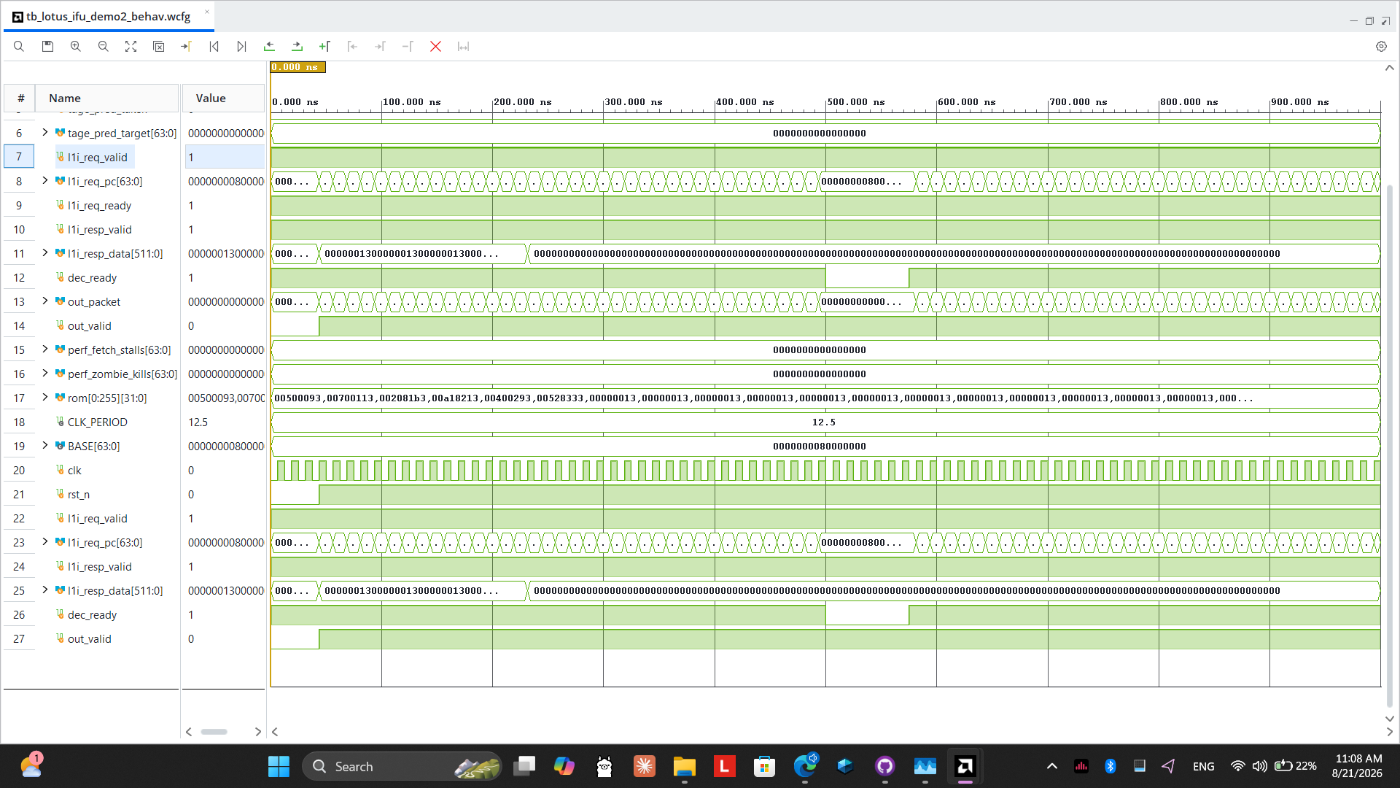
screenshots/Simulation Screenshots/Demo 2 screenshot 2.png
