Sanuka-cmd-net/lotus-omni/screenshots/Simulation Screenshots/Demo 3 screenshot.png

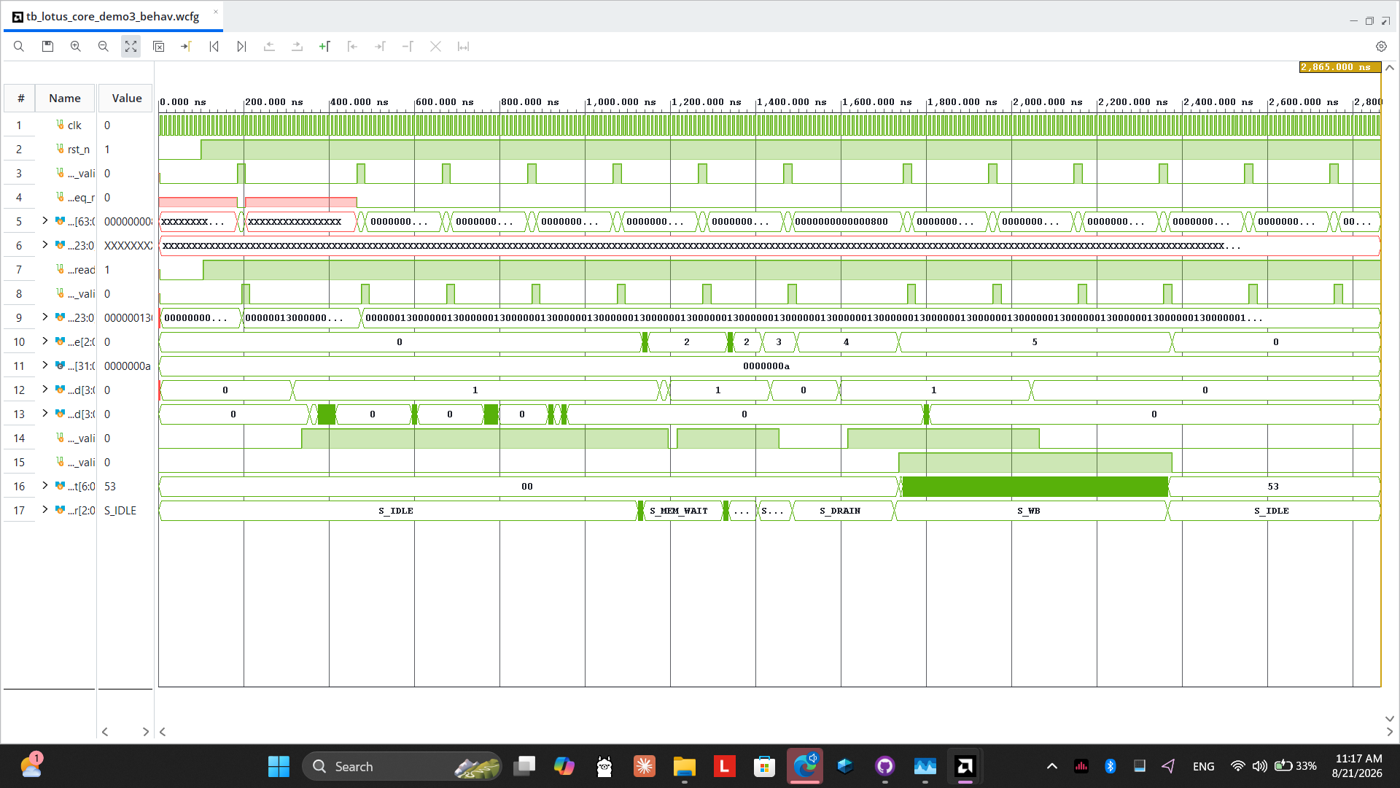
screenshots/Simulation Screenshots/Demo 3 screenshot.png
