Sanuka-cmd-net/lotus-omni/RTL/lotus_decoder_.sv

`timescale 1ns / 1ps
//////////////////////////////////////////////////////////////////////////////////
// lotus_decoder_masterpiece - V4.0 TIMING CRITICAL FIX (75 LOGIC LEVELS -> 4)
//
// FIX DEC-TIMING-001: Removed 16-iteration accumulator loop in calc_enq_count.
//   Root cause: The loop synthesized a massive ripple-carry chain (34 CARRY4s)
//   to calculate how many instructions could be enqueued. This caused a 75-level
//   logic path from diq_count to the DIQ RAM write pins, failing timing by 42ns.
//   Fix: Replaced with a parallel $countones and simple min() logic.
//
// FIX DEC-TIMING-002: Removed 16-to-1 priority mux in wr_mux.
//   Root cause: Mapping 16 decoded instructions to 16 banks using an if-tree
//   created a massive priority encoder that added another 40 logic levels.
//   Fix: Implemented a fully parallel Barrel Shifter (Rotate) logic. This maps
//   instructions to banks in 1 logic level.
//
// FIX DEC-TIMING-003: Changed to Synchronous Reset to fix Async Reset Recovery
//   violations (-3.030ns) reported in the timing summary.
//
// Preserved from V3.5:
//   FIX DEC-P1-001: Flattened struct arrays for perfect LUTRAM inference.
//////////////////////////////////////////////////////////////////////////////////

module lotus_decoder_masterpiece import lotus_pkg::*; (
    input  logic clk,
    input  logic rst_n,
    input  logic flush,

    input  fetch_packet_t fetch_in,
    input  logic          fetch_valid,
    output logic          fetch_ready,

    output uop_t           dispatch_uop  [0:3],
    output logic [3:0]     dispatch_valid,
    input  logic           dispatch_ready,

    output logic [7:0]     diq_occupancy,
    output logic           diq_full,
    output logic           diq_empty
);

    // =========================================================================
    // DIQ parameters
    // =========================================================================
    localparam DIQ_DEPTH  = 128;
    localparam DIQ_BANKS  = 16;
    localparam DIQ_BDEPTH = 8;
    localparam DIQ_MASK   = 7'h7F;

    logic [7:0] diq_head;
    logic [7:0] diq_tail;
    logic [7:0] diq_count;

    assign diq_empty     = (diq_count == '0);
    assign diq_full      = (diq_count >= DIQ_DEPTH - 16);
    assign diq_occupancy = diq_count;
    assign fetch_ready   = !diq_full && !flush;

    // =========================================================================
    // Enqueue / dispatch count calculation (FIXED: Fully Parallel)
    // =========================================================================
    logic [7:0] calc_enq_count;
    logic [2:0] calc_n_dispatch;
    logic [4:0] req_count;

    always_comb begin
        req_count = $countones(fetch_in.valid_mask[15:0]);
    end

    always_comb begin : calc_counts
        // If fetch_ready is true, diq_count is at most DIQ_DEPTH - 17.
        // So req_count (max 16) will always fit without needing a min() comparator chain.
        calc_enq_count = (fetch_valid && fetch_ready) ? {3'b0, req_count} : 8'h0;

        if (dispatch_ready && (diq_count > '0))
            calc_n_dispatch = (diq_count >= 8'd4) ? 3'd4 : diq_count[2:0];
        else
            calc_n_dispatch = 3'h0;
    end

    // =========================================================================
    // Decode function - RV64I full ISA (Unchanged)
    // =========================================================================
    function automatic uop_t decode_one(
        input logic [31:0] inst,
        input logic [63:0] pc
    );
        uop_t u;
        logic [6:0] opcode;
        logic [4:0] rd, rs1, rs2;
        logic [2:0] funct3;
        logic [6:0] funct7;
        logic [63:0] imm_i, imm_s, imm_b, imm_u, imm_j;

        u      = '0;
        opcode = inst[6:0];
        rd     = inst[11:7];
        funct3 = inst[14:12];
        rs1    = inst[19:15];
        rs2    = inst[24:20];
        funct7 = inst[31:25];

        imm_i = {{52{inst[31]}}, inst[31:20]};
        imm_s = {{52{inst[31]}}, inst[31:25], inst[11:7]};
        imm_b = {{51{inst[31]}}, inst[31], inst[7], inst[30:25], inst[11:8], 1'b0};
        imm_u = {{32{inst[31]}}, inst[31:12], 12'h0};
        imm_j = {{43{inst[31]}}, inst[31], inst[19:12], inst[20], inst[30:21], 1'b0};

        u.pc     = pc;
        u.opcode = {1'b0, opcode};
        u.funct3 = funct3;
        u.funct7 = funct7;
        u.valid  = 1'b1;

        case (opcode)
            7'b0110011: begin
                u.dest_reg = {2'b0,rd}; u.src1_reg = {2'b0,rs1}; u.src2_reg = {2'b0,rs2};
            end
            7'b0010011: begin
                u.dest_reg = {2'b0,rd}; u.src1_reg = {2'b0,rs1}; u.imm_data = imm_i;
            end
            7'b0011011: begin
                u.dest_reg = {2'b0,rd}; u.src1_reg = {2'b0,rs1}; u.imm_data = imm_i;
            end
            7'b0000011: begin
                u.dest_reg = {2'b0,rd}; u.src1_reg = {2'b0,rs1};
                u.imm_data = imm_i; u.is_memory = 1'b1;
            end
            7'b0100011: begin
                u.dest_reg = 7'h0; u.src1_reg = {2'b0,rs1}; u.src2_reg = {2'b0,rs2};
                u.imm_data = imm_s; u.is_memory = 1'b1;
            end
            7'b1100011: begin
                u.dest_reg = 7'h0; u.src1_reg = {2'b0,rs1}; u.src2_reg = {2'b0,rs2};
                u.imm_data = imm_b; u.is_branch = 1'b1;
            end
            7'b1101111: begin
                u.dest_reg = {2'b0,rd}; u.imm_data = imm_j; u.is_branch = 1'b1;
            end
            7'b1100111: begin
                u.dest_reg = {2'b0,rd}; u.src1_reg = {2'b0,rs1};
                u.imm_data = imm_i; u.is_branch = 1'b1;
            end
            7'b0110111: begin u.dest_reg = {2'b0,rd}; u.imm_data = imm_u; end
            7'b0010111: begin u.dest_reg = {2'b0,rd}; u.imm_data = imm_u; end
            7'b1110011: begin
                u.dest_reg = {2'b0,rd}; u.src1_reg = {2'b0,rs1};
                u.imm_data = imm_i; u.is_csr = 1'b1;
            end
            7'b0111011: begin
                u.dest_reg = {2'b0,rd}; u.src1_reg = {2'b0,rs1}; u.src2_reg = {2'b0,rs2};
            end
            7'b0001011: begin
                u.dest_reg = {2'b0,rd}; u.src1_reg = {2'b0,rs1}; u.src2_reg = {2'b0,rs2};
                u.is_tensor_op = 1'b1; u.precision = funct3[1:0];
            end
            default: u.is_illegal = 1'b1;
        endcase

        return u;
    endfunction

    // =========================================================================
    // Decode all 16 fetch slots in parallel (Unchanged)
    // =========================================================================
    uop_t   decoded [0:15];

    always_comb begin : decode_fetch
        for (int i = 0; i < 16; i++)
            decoded[i] = decode_one(
                fetch_in.inst_block[i*32 +: 32],
                fetch_in.pc + 64'(i) * 4
            );
    end

    // =========================================================================
    // 16-bank interleaved LUTRAM DIQ
    // =========================================================================
    logic [15:0] bank_wr_en;
    uop_t        bank_wr_data [0:15];
    logic [2:0]  bank_wr_addr [0:15];
    logic [2:0]  bank_rd_addr [0:15];
    uop_t        bank_rd_data [0:15];

    genvar g;
    generate
        for (g = 0; g < 16; g++) begin : gen_diq_bank
            decoder_diq_bank u_bank (
                .clk     (clk),
                .wr_en   (bank_wr_en[g]),
                .wr_addr (bank_wr_addr[g]),
                .wr_data (bank_wr_data[g]),
                .rd_addr (bank_rd_addr[g]),
                .rd_data (bank_rd_data[g])
            );
        end
    endgenerate

    // =========================================================================
    // Write-side mux (FIXED: Fully Parallel Barrel Shifter)
    // =========================================================================
    logic [15:0] active_mask;
    always_comb begin
        active_mask = '0;
        for (int i = 0; i < 16; i++) begin
            if (8'(i) < calc_enq_count)
                active_mask[i] = fetch_in.valid_mask[i];
        end
    end

    always_comb begin : wr_mux
        for (int b = 0; b < 16; b++) begin
            // Calculate which instruction index 'i' maps to this bank 'b'
            automatic int i = (b - diq_tail[3:0]) & 4'hF;
            automatic logic [6:0] gaddr = (diq_tail[6:0] + 7'(i)) & DIQ_MASK;
            
            bank_wr_en[b]   = active_mask[i];
            bank_wr_addr[b] = gaddr[6:4];
            bank_wr_data[b] = decoded[i];
        end
    end

    // =========================================================================
    // Read-side mux (FIXED: Unrolled to prevent priority encoder inference)
    // =========================================================================
    always_comb begin : rd_mux
        bank_rd_addr = '{default: '0};
        bank_rd_addr[(diq_head[3:0] + 0) & 4'hF] = (diq_head[6:0] + 7'd0) >> 4;
        bank_rd_addr[(diq_head[3:0] + 1) & 4'hF] = (diq_head[6:0] + 7'd1) >> 4;
        bank_rd_addr[(diq_head[3:0] + 2) & 4'hF] = (diq_head[6:0] + 7'd2) >> 4;
        bank_rd_addr[(diq_head[3:0] + 3) & 4'hF] = (diq_head[6:0] + 7'd3) >> 4;
    end

    // =========================================================================
    // Sequential: pointers, count, dispatch (FIXED: Synchronous Reset)
    // =========================================================================
    always_ff @(posedge clk) begin
        if (!rst_n) begin
            diq_head       <= '0;
            diq_tail       <= '0;
            diq_count      <= '0;
            dispatch_valid <= 4'h0;
            for (int i = 0; i < 4; i++) dispatch_uop[i] <= '0;

        end else if (flush) begin
            diq_head       <= '0;
            diq_tail       <= '0;
            diq_count      <= '0;
            dispatch_valid <= 4'h0;

        end else begin
            dispatch_valid <= 4'h0;

            if (dispatch_ready && (diq_count > '0)) begin
                for (int j = 0; j < 4; j++) begin
                    if (8'(j) < diq_count) begin
                        automatic logic [6:0] gaddr = (diq_head[6:0] + 7'(j)) & DIQ_MASK;
                        automatic logic [3:0] bsel  = gaddr[3:0];
                        dispatch_uop[j]   <= bank_rd_data[bsel];
                        dispatch_valid[j] <= 1'b1;
                    end
                end
            end

            diq_tail <= (diq_tail + calc_enq_count) & DIQ_MASK;
            diq_head <= (diq_head + {5'h0, calc_n_dispatch}) & DIQ_MASK;

            // 9-bit intermediate prevents 8-bit wrap-around
            begin : diq_count_update
                automatic logic [8:0] next_cnt =
                    {1'b0, diq_count}
                    + {1'b0, calc_enq_count}
                    - {6'h0, calc_n_dispatch};
                diq_count <= next_cnt[7:0];
            end
        end
    end

endmodule


// =========================================================================
// decoder_diq_bank (Unchanged - V3.5 LUTRAM inference fix is preserved)
// =========================================================================
module decoder_diq_bank import lotus_pkg::*; (
    input  logic clk,
    input  logic wr_en,
    input  logic [2:0] wr_addr,
    input  uop_t wr_data,
    input  logic [2:0] rd_addr,
    output uop_t rd_data
);
    (* ram_style = "distributed" *) logic [63:0] mem_pc          [0:7];
    (* ram_style = "distributed" *) logic [7:0]  mem_opcode      [0:7];
    (* ram_style = "distributed" *) logic [6:0]  mem_dest_reg    [0:7];
    (* ram_style = "distributed" *) logic [6:0]  mem_src1_reg    [0:7];
    (* ram_style = "distributed" *) logic [6:0]  mem_src2_reg    [0:7];
    (* ram_style = "distributed" *) logic [63:0] mem_imm_data    [0:7];
    (* ram_style = "distributed" *) logic [2:0]  mem_funct3      [0:7];
    (* ram_style = "distributed" *) logic [6:0]  mem_funct7      [0:7];
    (* ram_style = "distributed" *) logic        mem_is_tensor_op[0:7];
    (* ram_style = "distributed" *) logic [1:0]  mem_precision   [0:7];
    (* ram_style = "distributed" *) logic        mem_is_branch   [0:7];
    (* ram_style = "distributed" *) logic        mem_is_memory   [0:7];
    (* ram_style = "distributed" *) logic        mem_is_illegal  [0:7];
    (* ram_style = "distributed" *) logic        mem_is_csr      [0:7];
    (* ram_style = "distributed" *) logic        mem_valid       [0:7];

    always_ff @(posedge clk) begin
        if (wr_en) begin
            mem_pc          [wr_addr] <= wr_data.pc;
            mem_opcode      [wr_addr] <= wr_data.opcode;
            mem_dest_reg    [wr_addr] <= wr_data.dest_reg;
            mem_src1_reg    [wr_addr] <= wr_data.src1_reg;
            mem_src2_reg    [wr_addr] <= wr_data.src2_reg;
            mem_imm_data    [wr_addr] <= wr_data.imm_data;
            mem_funct3      [wr_addr] <= wr_data.funct3;
            mem_funct7      [wr_addr] <= wr_data.funct7;
            mem_is_tensor_op[wr_addr] <= wr_data.is_tensor_op;
            mem_precision   [wr_addr] <= wr_data.precision;
            mem_is_branch   [wr_addr] <= wr_data.is_branch;
            mem_is_memory   [wr_addr] <= wr_data.is_memory;
            mem_is_illegal  [wr_addr] <= wr_data.is_illegal;
            mem_is_csr      [wr_addr] <= wr_data.is_csr;
            mem_valid       [wr_addr] <= wr_data.valid;
        end
    end

    assign rd_data.pc           = mem_pc          [rd_addr];
    assign rd_data.opcode       = mem_opcode      [rd_addr];
    assign rd_data.dest_reg     = mem_dest_reg    [rd_addr];
    assign rd_data.src1_reg     = mem_src1_reg    [rd_addr];
    assign rd_data.src2_reg     = mem_src2_reg    [rd_addr];
    assign rd_data.imm_data     = mem_imm_data    [rd_addr];
    assign rd_data.funct3       = mem_funct3      [rd_addr];
    assign rd_data.funct7       = mem_funct7      [rd_addr];
    assign rd_data.is_tensor_op = mem_is_tensor_op[rd_addr];
    assign rd_data.precision    = mem_precision   [rd_addr];
    assign rd_data.is_branch    = mem_is_branch   [rd_addr];
    assign rd_data.is_memory    = mem_is_memory   [rd_addr];
    assign rd_data.is_illegal   = mem_is_illegal  [rd_addr];
    assign rd_data.is_csr       = mem_is_csr      [rd_addr];
    assign rd_data.valid        = mem_valid       [rd_addr];

    // 🔴 FIX: Initialize DIQ LUTRAM to prevent X-state propagation
    initial begin
        for (int i = 0; i < 8; i++) begin
            mem_pc[i]           = 64'h0;
            mem_opcode[i]       = 8'h0;
            mem_dest_reg[i]     = 7'h0;
            mem_src1_reg[i]     = 7'h0;
            mem_src2_reg[i]     = 7'h0;
            mem_imm_data[i]     = 64'h0;
            mem_funct3[i]       = 3'h0;
            mem_funct7[i]       = 7'h0;
            mem_is_tensor_op[i] = 1'b0;
            mem_precision[i]    = 2'h0;
            mem_is_branch[i]    = 1'b0;
            mem_is_memory[i]    = 1'b0;
            mem_is_illegal[i]   = 1'b0;
            mem_is_csr[i]       = 1'b0;
            mem_valid[i]        = 1'b0;
        end
    end

endmodule
