Sanuka-cmd-net/lotus-omni/(commit log)

2026-08-07 Tensor dataflow + L1D full-line: MATMUL 64/64 verified, timing +0.141ns
    - Outer-product broadcast systolic arrays (BF16 V5.1 / INT8 V2.0), local accumulation (PE V10.0)
    - Tensor Engine v3.0.0 dataflow alignment: array_enable during FEED+DRAIN, feed_first, column-wise activation feed
    - L1D V8.0 full 512-bit line response; top V10.0 scalar word-select
    - Self-checking TB: PASS 64/64 (2*3*8 = 48 = 0x30)
    - Timing closed OOC @ 80 MHz: WNS +0.141 ns, 0 / 157,103 failing endpoints
    - Utilization: 55,450 LUT / 38,173 FF / 17 BRAM / 64 DSP, 0 latches
    - Updated ARCHITECTURE.md + raw Vivado reports (timing/utilization/DRC)
    [lotus_bf16_systolic_array_8x8.sv, lotus_bf16_tensor_pe.sv, lotus_int8_systolic_array_8x8.sv, lotus_l1d_cache.sv, lotus_omni_core_top_v2.sv, lotus_tensor_engine.sv, tb_lotus_axi4_wrapper (Demo 1).sv, tb_lotus_core.sv]
2026-08-07 Add Vivado design + simulation screenshots; update README
    - Vivado design evidence: dataflow, elaborated, synthesized, implemented, schematic
    - Simulation demos: Demo 1 (AXI), Demo 2 (IFU), Demo 3 (full-core + tensor 64/64)
    - README updated with Mermaid architecture diagram + verified results
2026-08-22 > **LOTUS OMNI** is a tape-out-class, 4-wide superscalar out-of-order RISC-V edge processor featuring a custom 8×8 systolic tensor engine (BF16/INT8 with 2:4 structured sparsity), a credit-based 2D m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
    A 4-wide superscalar out-of-order RISC-V processor fused with an 8x8 systolic AI tensor accelerator, 2D mesh NoC, and 3-level cache. Timing closed at 80MHz (166k endpoints, WNS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
    [Lotus l1i cache.sv, lotus_alu_masterpiece.sv, lotus_branch_exec.sv, lotus_csr.sv, lotus_decoder_.sv, lotus_flow_control_gate.sv, lotus_l1d_cache.sv, lotus_lsq_masterpiece.sv]
